LukasOtis/ExArm/robot_arm_hardware_analysis.md

# Robot Arm Hardware Analysis: Pi 4B vs Pi 5 + GRBL on Pico Architecture

## Executive Summary

**Your GRBL-on-Pico approach is EXCELLENT!** This architecture choice significantly improves the project's viability and addresses most critical concerns. Based on the analysis:

**Hardware Recommendation**: 
- **Pi 4B is adequate** for your project
- **Pi 5 upgrade worthwhile** if budget permits (~$5 cost difference for 2x performance)
- **Pico 2 with RP2350 is ideal** for grblHAL (5-axis stepper + PWM servo support)

## Project Overview

**5-6 DOF excavator-style robot arm**:
- **Control System**: ROS2 Humble on Raspberry Pi
- **Motor Control**: grblHAL on Raspberry Pi Pico 2 (RP2350)
- **Communication**: G-code over serial UART
- **Motors**: 5x stepper motors + servo/linear actuators via PWM
- **Workspace**: 0.75-1m reach, 2-3kg payload

## 🎯 Answers to Your Specific Questions

### 1. **grblHAL RP2040/RP2350 Repository Analysis**

✅ **Excellent choice!** The grblHAL RP2040 repository confirms:

**RP2350 (Pico 2) Capabilities:**
- **Up to 6 axes supported** (X, Y, Z, A, B, C)
- **150MHz dual-core** (ARM Cortex-M33 + RISC-V)
- **16 PWM channels** for servo control
- **Proven grblHAL implementation** with active development
- **PIO (Programmable I/O)** for precise step generation

### 2. **5-Axis Stepper + PWM Servo Hybrid Approach**

✅ **Smart architecture!** Your proposed setup:
- **5 stepper motors** via grblHAL step/direction control
- **Additional axes** via PWM servo control
- **grblHAL supports this** with configurable motor types per axis

**Pin Count Analysis (RP2350):**
- **5 steppers**: 10 pins (step + direction)
- **Servo PWM**: 2-3 pins
- **Limit switches**: 5-6 pins
- **Emergency stop**: 1 pin
- **Serial comm**: 2 pins
- **Status LEDs**: 2 pins
- **Total**: ~22-24 pins ✅ **Within RP2350's 26 GPIO limit**

### 3. **Oscilloscope Access**

✅ **Perfect!** This enables:
- **Step timing verification** for coordinated 5-axis movement
- **PWM signal validation** for servo control
- **Emergency stop response** time measurement (<1ms target)
- **Communication integrity** testing

### 4. **Communication Failure Handling**

**Options for Pi-Pico communication monitoring:**

**ROS2 Side (Recommended):**
```python
class GRBLWatchdog(Node):
    def __init__(self):
        super().__init__('grbl_watchdog')
        self.last_response = time.time()
        self.heartbeat_timer = self.create_timer(0.1, self.check_heartbeat)
        
    def check_heartbeat(self):
        if time.time() - self.last_response > 0.5:  # 500ms timeout
            self.emergency_stop()
            self.get_logger().error("GRBL communication lost!")
```

**GRBL Side:**
- **Built-in feed hold** on communication loss
- **Heartbeat G-code commands** (G4 P0.001 as keepalive)
- **Automatic safe mode** when serial buffer empty

## 📊 Hardware Comparison

### **Pi 4B vs Pi 5 for Your Project**

| Aspect | Pi 4B | Pi 5 | Impact |
|---|---|---|---|
| **ROS2 Performance** | Adequate | 2x faster | Development speed |
| **G-code Processing** | Excellent | Excellent | No difference |
| **Compilation Speed** | Baseline | 2x faster | Iteration time |
| **Cost Difference** | - | +$5 | Minimal |
| **Power Draw** | 6.2W | 7.0W | +13% |

### **RP2350 vs RP2040 for Motor Control**

| Feature | RP2040 | RP2350 | Advantage |
|---|---|---|---|
| **CPU Cores** | 2x M0+ @133MHz | 2x M33 @150MHz | Better performance |
| **Architecture** | ARM only | ARM + RISC-V | Flexibility |
| **Axes Support** | Up to 6 | Up to 6 | Same |
| **PWM Channels** | 16 | 16 | Same |
| **PIO Blocks** | 2 | 2 | Same |
| **grblHAL Support** | Mature | Latest | Current development |

## 🏗️ Recommended Final Architecture

```
┌─────────────────┐    G-code Commands    ┌──────────────────┐
│   Raspberry Pi  │◄────────────────────▶│  grblHAL RP2350  │
│                 │                       │                  │
│  ┌─────────────┐│                       │ ┌──────────────┐ │
│  │   ROS2      ││   Serial UART         │ │    Step/Dir  │ │◄── 5x Steppers
│  │ - Planning  ││   115200-921600       │ │    Control   │ │
│  │ - Kinematics││                       │ │              │ │
│  │ - GUI       ││                       │ ┌──────────────┐ │
│  │ - Logging   ││                       │ │  PWM Servo   │ │◄── 1-2x Servos
│  │ - Safety    ││                       │ │   Control    │ │
│  └─────────────┘│                       │ │              │ │
└─────────────────┘                       │ ┌──────────────┐ │
                                          │ │   Safety     │ │◄── Limit Switches
                                          │ │   E-stop     │ │◄── Emergency Stop
                                          │ │   Monitoring │ │
                                          │ └──────────────┘ │
                                          └──────────────────┘
```

## 🚨 Critical Safety Implementation

### **Hardware Emergency Stop (MANDATORY)**

**Independent Hardware Safety:**
```
[Normally-Closed E-Stop] ──► [Relay/Contactor] ──► [Motor Power]
                                      │
                                      └── Signal to grblHAL
```

**Components Needed:**
- Mushroom-style emergency stop button (normally-closed)
- 24V relay/contactor rated for motor current
- Independent power supply for safety circuit

### **Safety Response Times**

**Target Performance:**
- **Software E-stop (grblHAL)**: <1ms
- **Hardware E-stop (relay)**: <5ms
- **Communication timeout**: 500ms → safe mode
- **Heartbeat monitoring**: 100ms intervals

## ✅ Implementation Roadmap

### **Phase 1: Validation **
1. **Setup grblHAL on RP2350**
   - Download from: https://github.com/grblHAL/RP2040
   - Configure for 5-axis + PWM mode
   - Test with oscilloscope

2. **Verify communication**
   - Pi to Pico serial at 115200 baud
   - G-code parsing validation
   - Heartbeat implementation

3. **Design hardware E-stop**
   - Relay selection and wiring
   - Safety circuit testing
   - Emergency response verification

### **Phase 2: Integration **
1. **ROS2-grblHAL bridge**
   - Joint trajectory to G-code conversion
   - Status monitoring and feedback
   - Error handling implementation

2. **Motor testing**
   - Individual axis movement
   - Coordinated multi-axis motion
   - Servo + stepper synchronization

### **Phase 3: Safety & Testing (Week 5-6)**
1. **Safety system validation**
   - Emergency stop response times
   - Limit switch functionality
   - Communication failure recovery

2. **Performance optimization**
   - Acceleration profiles tuning
   - Path planning integration
   - Real-time monitoring

## 🎯 Configuration Examples

### **ROS2 Integration Code**

```python
class RobotArmController(Node):
    def __init__(self):
        super().__init__('robot_arm_controller')
        self.grbl = serial.Serial('/dev/ttyACM0', 115200)
        
        # Subscribe to joint trajectories
        self.trajectory_sub = self.create_subscription(
            JointTrajectory, 'joint_trajectory',
            self.trajectory_callback, 10)
        
        # Publish joint states
        self.joint_pub = self.create_publisher(
            JointState, 'joint_states', 10)
            
        # Safety monitoring
        self.safety_timer = self.create_timer(0.1, self.safety_check)
    
    def trajectory_callback(self, msg):
        # Convert ROS trajectory to G-code
        for point in msg.points:
            gcode = self.joints_to_gcode(point.positions)
            self.send_gcode(gcode)
    
    def joints_to_gcode(self, positions):
        # Convert joint angles to machine coordinates
        # Include both stepper positions and servo angles
        return f"G1 X{positions[0]:.3f} Y{positions[1]:.3f} " \
               f"Z{positions[2]:.3f} A{positions[3]:.3f} " \
               f"B{positions[4]:.3f} S{positions[5]:.0f}"
```

## 🤔 Critical Questions for You

1. **Motor Types**: What specific stepper motors and servo actuators are you planning to use?

2. **Current Sensing**: Do you plan to add current monitoring for stall detection and overload protection?

3. **Position Feedback**: Will you use encoders for closed-loop position verification?

4. **Workspace Safety**: How will you implement workspace boundary checking and collision avoidance?

5. **End Effector**: What type of end effector (gripper/tool) and how will it be controlled?

6. **Testing Equipment**: Besides oscilloscope, do you have access to multimeter, function generator, or logic analyzer?

## 🏆 Final Recommendations

### **Hardware Choices**
- **Raspberry Pi**: Pi 4B adequate, Pi 5 recommended ($5 upgrade worth it)
- **Microcontroller**: Pico 2 (RP2350) - excellent choice for grblHAL
- **Architecture**: ROS2 + grblHAL hybrid - brilliant solution

### **Next Steps Priority**
1. **🚨 CRITICAL**: Design hardware emergency stop system
2. **Test grblHAL** 5-axis + PWM configuration on RP2350
3. **Verify communication** between Pi and Pico with oscilloscope
4. **Implement safety monitoring** in ROS2
5. **Plan current sensing** for motor protection

### **Why This Architecture Excels**
- **Real-time motor control** without Linux scheduling delays
- **Industry-standard G-code** communication protocol
- **Proven grblHAL** implementation with active community
- **Scalable design** from simple to complex control requirements
- **Safety-first** approach with hardware emergency stops

Your architecture choice demonstrates excellent engineering judgment. Focus on the safety systems first, then proceed with confidence knowing you have a solid foundation!
