LukasOtis/ExArm/docs/TECHNICAL_ARCHITECTURE.md

# Technical Architecture

## System Overview
The robot arm control system consists of three main components:
1. **Raspberry Pi** - ROS2 control system
2. **Raspberry Pi Pico** - Motor control and hardware interface
3. **Robot Arm Hardware** - Stepper motors, encoders, and mechanical components

## Communication Architecture

### ROS2 Node Structure
```
robot_arm_control/
├── robot_arm_hardware_interface/    # Hardware abstraction layer
├── robot_arm_controller/            # Joint trajectory controller
├── robot_arm_planning/              # Path planning and optimization
├── robot_arm_gui/                   # Manual control interface
└── robot_arm_description/           # Robot model and parameters
```

### Communication Flow
```
GUI/Planning → Controller → Hardware Interface → Serial → Pico → Motors
     ↑                                                           ↓
     └────────────── Joint States ←──────────────────────────────┘
```

## Hardware Interface Design

### Serial Protocol (RPi ↔ Pico)
```
Message Format:
[START][CMD][DATA][CHECKSUM][END]

Commands:
- MOVE: Move joint to position
- HOME: Home all joints
- STATUS: Get current status
- EMERGENCY_STOP: Emergency stop
- SET_LIMITS: Set joint limits
- GET_POSITION: Get current position
```

### Joint Configuration
```
Joint 1: Base rotation (0-360°)
Joint 2: Shoulder rotation (0-180°)
Joint 3: Elbow rotation (0-180°)
Joint 4: Linear actuator 1 (0-100mm)
Joint 5: Linear actuator 2 (0-100mm)
Joint 6: End effector rotation (0-360°)
```

## Control System Architecture

### Joint Trajectory Controller
- **Input**: Trajectory messages from planning
- **Output**: Joint commands to hardware interface
- **Features**: 
  - Velocity and acceleration limits
  - Joint limit enforcement
  - Emergency stop handling

### Hardware Interface Node
- **Responsibilities**:
  - Serial communication management
  - Joint state publishing
  - Command execution
  - Error handling and recovery
  - Safety limit enforcement

### Safety System
- **Software Limits**: Joint angle and velocity limits
- **Hardware Limits**: Physical end stops and emergency stops
- **Emergency Stop**: Immediate halt of all movement
- **Collision Detection**: Workspace boundary checking

## Data Flow

### Control Commands
```
1. GUI/Planning sends trajectory goal
2. Controller validates trajectory
3. Controller sends joint commands to hardware interface
4. Hardware interface sends serial commands to Pico
5. Pico executes motor movements
6. Encoder feedback returns through same path
7. Joint states published for monitoring
```

### Safety Monitoring
```
1. Hardware interface monitors encoder feedback
2. Safety limits checked in real-time
3. Emergency stop triggered if limits exceeded
4. Status published to safety monitoring node
5. GUI updated with current status
```

## Performance Requirements

### Timing
- **Control Loop**: 50Hz (20ms period)
- **Safety Check**: 100Hz (10ms period)
- **GUI Update**: 10Hz (100ms period)
- **Serial Communication**: 115200 baud

### Latency Targets
- **Command to Motor**: < 50ms
- **Encoder to Joint State**: < 20ms
- **Emergency Stop**: < 10ms

## Error Handling

### Communication Errors
- Serial connection timeout handling
- Automatic reconnection attempts
- Fallback to safe positions

### Hardware Errors
- Motor stall detection
- Encoder failure handling
- Power loss recovery

### Software Errors
- Trajectory validation failures
- Controller errors
- Planning algorithm failures

## Development Phases

### Phase 1: Basic Control
- Simple joint movement commands
- Basic safety limits
- Manual control interface

### Phase 2: Advanced Control
- Trajectory following
- Path planning integration
- Advanced safety features

### Phase 3: Optimization
- Performance tuning
- Error recovery improvements
- User interface enhancements

## Testing Strategy

### Unit Testing
- Individual node testing
- Hardware interface simulation
- Controller algorithm validation

### Integration Testing
- End-to-end system testing
- Performance benchmarking
- Safety system validation

### Hardware Testing
- Real hardware integration
- Load testing
- Long-term reliability testing
