LukasOtis/ExArm/docs/PROJECT_STATUS.md

# Project Status Tracker

## Current Status: Phase 1 - Environment Setup
**Start Date**: [To be filled]
**Target Completion**: [To be filled]
**Progress**: 0% Complete

## Phase Progress

### Phase 1: Environment Setup (Week 1-2)
**Status**: 🔄 In Progress
**Progress**: 0/7 tasks completed

- [ ] **Day 1-2**: Install Ubuntu 22.04 in virtual environment
- [ ] **Day 3-4**: Install ROS2 Humble and development tools
- [ ] **Day 5**: Set up ROS2 workspace structure
- [ ] **Day 6-7**: Install Gazebo, RViz, and simulation tools
- [ ] **Week 2 Day 1-2**: Create project repository structure
- [ ] **Week 2 Day 3-4**: Set up development environment (IDE, debugging tools)
- [ ] **Week 2 Day 5-6**: Create initial robot description package
- [ ] **Week 2 Day 7**: Test basic ROS2 installation and tools

**Milestone 1**: Functional ROS2 environment with basic workspace
**Status**: ❌ Not Started

### Phase 2: Simulation & Design (Week 3-6)
**Status**: ⏳ Pending
**Progress**: 0/20 tasks completed

- [ ] **Week 3 Day 1-3**: Design robot URDF/XACRO structure
- [ ] **Week 3 Day 4-5**: Implement basic joint definitions
- [ ] **Week 3 Day 6-7**: Create visualization in RViz
- [ ] **Week 4 Day 1-3**: Set up Gazebo simulation environment
- [ ] **Week 4 Day 4-5**: Implement basic kinematics calculations
- [ ] **Week 4 Day 6-7**: Test joint limits and workspace simulation
- [ ] **Week 5 Day 1-3**: Design hardware interface architecture
- [ ] **Week 5 Day 4-5**: Plan serial communication protocol
- [ ] **Week 5 Day 6-7**: Create motor control interface design
- [ ] **Week 6 Day 1-3**: Implement basic trajectory planning
- [ ] **Week 6 Day 4-5**: Create safety limit implementations
- [ ] **Week 6 Day 6-7**: Test simulation with basic movements

**Milestone 2**: Functional simulation with basic control
**Status**: ❌ Not Started

### Phase 3: Core Control System (Week 7-10)
**Status**: ⏳ Pending
**Progress**: 0/20 tasks completed

- [ ] **Week 7 Day 1-3**: Create hardware interface package structure
- [ ] **Week 7 Day 4-5**: Implement serial communication with Pico
- [ ] **Week 7 Day 6-7**: Basic motor control interface
- [ ] **Week 8 Day 1-3**: Implement joint trajectory controller
- [ ] **Week 8 Day 4-5**: Create joint state publisher
- [ ] **Week 8 Day 6-7**: Test controller with simulation
- [ ] **Week 9 Day 1-3**: Implement safety limits and end stops
- [ ] **Week 9 Day 4-5**: Create emergency stop functionality
- [ ] **Week 9 Day 6-7**: Basic manual control interface
- [ ] **Week 10 Day 1-3**: Integrate hardware interface with simulation
- [ ] **Week 10 Day 4-5**: Test end-to-end control system
- [ ] **Week 10 Day 6-7**: Performance optimization and debugging

**Milestone 3**: Functional control system with safety features
**Status**: ❌ Not Started

### Phase 4: Advanced Features (Week 11-14)
**Status**: ⏳ Pending
**Progress**: 0/20 tasks completed

- [ ] **Week 11 Day 1-3**: Implement path planning algorithms
- [ ] **Week 11 Day 4-5**: Create trajectory optimization
- [ ] **Week 11 Day 6-7**: Test planning with complex paths
- [ ] **Week 12 Day 1-3**: Develop GUI for manual control
- [ ] **Week 12 Day 4-5**: Implement real-time position display
- [ ] **Week 12 Day 6-7**: Add manual joint control interface
- [ ] **Week 13 Day 1-3**: Implement error handling and recovery
- [ ] **Week 13 Day 4-5**: Add logging and debugging tools
- [ ] **Week 13 Day 6-7**: Create system monitoring interface
- [ ] **Week 14 Day 1-3**: Optimize control loop performance
- [ ] **Week 14 Day 4-5**: Implement advanced safety features
- [ ] **Week 14 Day 6-7**: Finalize GUI and user interface

**Milestone 4**: Complete control system with advanced features
**Status**: ❌ Not Started

### Phase 5: Testing & Integration (Week 15-18)
**Status**: ⏳ Pending
**Progress**: 0/20 tasks completed

- [ ] **Week 15 Day 1-3**: Hardware integration testing
- [ ] **Week 15 Day 4-5**: Real-world performance testing
- [ ] **Week 15 Day 6-7**: Calibration and tuning
- [ ] **Week 16 Day 1-3**: Load testing and stress testing
- [ ] **Week 16 Day 4-5**: Safety system validation
- [ ] **Week 16 Day 6-7**: Performance optimization
- [ ] **Week 17 Day 1-3**: Documentation completion
- [ ] **Week 17 Day 4-5**: User manual creation
- [ ] **Week 17 Day 6-7**: Code documentation and comments
- [ ] **Week 18 Day 1-3**: Final testing and validation
- [ ] **Week 18 Day 4-5**: Bug fixes and improvements
- [ ] **Week 18 Day 6-7**: Project completion and handover

**Milestone 5**: Production-ready robot arm control system
**Status**: ❌ Not Started

## Overall Project Metrics

### Timeline
- **Total Duration**: 18 weeks
- **Current Week**: 1
- **Weeks Remaining**: 17
- **Overall Progress**: 0%

### Risk Assessment
- **Hardware Design**: 🟡 Medium Risk (CAD design ongoing)
- **Software Complexity**: 🟢 Low Risk (Modular design)
- **Timeline**: 🟢 Low Risk (Realistic milestones)
- **Resource Availability**: 🟢 Low Risk (20 hours/week available)

### Success Metrics
- [ ] Robot arm responds to commands within 100ms
- [ ] Safety systems prevent dangerous movements
- [ ] GUI provides intuitive manual control
- [ ] Path planning handles complex trajectories
- [ ] System operates reliably for extended periods

## Weekly Updates

### Week 1 (Current)
**Focus**: RPi Environment Setup with X11 Forwarding
**Goals**:
- [ ] Set up RPi with ROS2 and X11 forwarding
- [ ] Install Cursor IDE and Remote-SSH extension
- [ ] Test X11 forwarding and RViz visualization
- [ ] Set up development workspace on RPi

**Challenges**: None identified yet
**Next Week**: Complete RPi setup and begin robot description with visualization

## Notes and Decisions

### Technical Decisions
- **ROS2 Version**: Humble (LTS)
- **Programming Language**: C++ for performance-critical components, Python for GUI
- **Communication Protocol**: Serial UART between RPi and Pico
- **Control Frequency**: 50Hz target

### Architecture Decisions
- **Modular Design**: Separate packages for different functionalities
- **Safety First**: Multiple safety layers (hardware + software)
- **Simulation Driven**: Develop and test in simulation before hardware

### Resource Allocation
- **Development Time**: 20 hours/week
- **Hardware Budget**: TBD
- **Software Tools**: Open source (ROS2, Gazebo, RViz)

## Action Items

### Immediate (This Week)
1. Set up virtual environment
2. Install ROS2 Humble
3. Test basic ROS2 functionality
4. Create initial project structure

### Short Term (Next 2 Weeks)
1. Complete environment setup
2. Create basic robot description
3. Set up visualization tools
4. Begin simulation development

### Medium Term (Next Month)
1. Implement basic control system
2. Design hardware interface
3. Create safety systems
4. Develop manual control interface

## Contact and Support
- **Project Lead**: [Your Name]
- **Technical Lead**: [Your Name]
- **Documentation**: This repository
- **Issues**: GitHub Issues
- **Discussions**: GitHub Discussions
