LukasOtis/ExArm/docs/PROJECT_TIMELINE.md

# ROS2 Robot Arm Project Timeline

## Phase 1: Environment Setup (Week 1-2)
**Goal**: Establish development environment and project structure

### Week 1
- [ ] **Day 1-2**: Set up RPi with ROS2 and X11 forwarding
- [ ] **Day 3-4**: Install Cursor IDE and Remote-SSH extension
- [ ] **Day 5**: Test X11 forwarding and RViz visualization
- [ ] **Day 6-7**: Set up development workspace and test robot model

### Week 2
- [ ] **Day 1-2**: Create project repository structure on RPi
- [ ] **Day 3-4**: Set up development environment with Cursor remote SSH
- [ ] **Day 5-6**: Create initial robot description package and test visualization
- [ ] **Day 7**: Test basic ROS2 installation and X11 forwarding

**Milestone 1**: Functional ROS2 environment with X11 forwarding and visualization

## Phase 2: Simulation & Design (Week 3-6)
**Goal**: Create simulation environment and robot description

### Week 3
- [ ] **Day 1-3**: Design robot URDF/XACRO structure
- [ ] **Day 4-5**: Implement basic joint definitions
- [ ] **Day 6-7**: Create visualization in RViz

### Week 4
- [ ] **Day 1-3**: Set up Gazebo simulation environment
- [ ] **Day 4-5**: Implement basic kinematics calculations
- [ ] **Day 6-7**: Test joint limits and workspace simulation

### Week 5
- [ ] **Day 1-3**: Design hardware interface architecture
- [ ] **Day 4-5**: Plan serial communication protocol
- [ ] **Day 6-7**: Create motor control interface design

### Week 6
- [ ] **Day 1-3**: Implement basic trajectory planning
- [ ] **Day 4-5**: Create safety limit implementations
- [ ] **Day 6-7**: Test simulation with basic movements

**Milestone 2**: Functional simulation with basic control

## Phase 3: Core Control System (Week 7-10)
**Goal**: Implement hardware interface and basic control

### Week 7
- [ ] **Day 1-3**: Create hardware interface package structure
- [ ] **Day 4-5**: Implement serial communication with Pico
- [ ] **Day 6-7**: Basic motor control interface

### Week 8
- [ ] **Day 1-3**: Implement joint trajectory controller
- [ ] **Day 4-5**: Create joint state publisher
- [ ] **Day 6-7**: Test controller with simulation

### Week 9
- [ ] **Day 1-3**: Implement safety limits and end stops
- [ ] **Day 4-5**: Create emergency stop functionality
- [ ] **Day 6-7**: Basic manual control interface

### Week 10
- [ ] **Day 1-3**: Integrate hardware interface with simulation
- [ ] **Day 4-5**: Test end-to-end control system
- [ ] **Day 6-7**: Performance optimization and debugging

**Milestone 3**: Functional control system with safety features

## Phase 4: Advanced Features (Week 11-14)
**Goal**: Implement advanced control and planning features

### Week 11
- [ ] **Day 1-3**: Implement path planning algorithms
- [ ] **Day 4-5**: Create trajectory optimization
- [ ] **Day 6-7**: Test planning with complex paths

### Week 12
- [ ] **Day 1-3**: Develop GUI for manual control
- [ ] **Day 4-5**: Implement real-time position display
- [ ] **Day 6-7**: Add manual joint control interface

### Week 13
- [ ] **Day 1-3**: Implement error handling and recovery
- [ ] **Day 4-5**: Add logging and debugging tools
- [ ] **Day 6-7**: Create system monitoring interface

### Week 14
- [ ] **Day 1-3**: Optimize control loop performance
- [ ] **Day 4-5**: Implement advanced safety features
- [ ] **Day 6-7**: Finalize GUI and user interface

**Milestone 4**: Complete control system with advanced features

## Phase 5: Testing & Integration (Week 15-18)
**Goal**: Hardware integration and final testing

### Week 15
- [ ] **Day 1-3**: Hardware integration testing
- [ ] **Day 4-5**: Real-world performance testing
- [ ] **Day 6-7**: Calibration and tuning

### Week 16
- [ ] **Day 1-3**: Load testing and stress testing
- [ ] **Day 4-5**: Safety system validation
- [ ] **Day 6-7**: Performance optimization

### Week 17
- [ ] **Day 1-3**: Documentation completion
- [ ] **Day 4-5**: User manual creation
- [ ] **Day 6-7**: Code documentation and comments

### Week 18
- [ ] **Day 1-3**: Final testing and validation
- [ ] **Day 4-5**: Bug fixes and improvements
- [ ] **Day 6-7**: Project completion and handover

**Milestone 5**: Production-ready robot arm control system

## Risk Mitigation
- **Hardware delays**: Continue with simulation development
- **Software complexity**: Focus on core functionality first
- **Performance issues**: Implement modular design for easy optimization
- **Safety concerns**: Implement multiple safety layers

## Success Criteria
- [ ] Robot arm responds to commands within 100ms
- [ ] Safety systems prevent dangerous movements
- [ ] GUI provides intuitive manual control
- [ ] Path planning handles complex trajectories
- [ ] System operates reliably for extended periods
