LukasOtis/ExArm/hardware/pcb/controller_board/assembly/BOM_with_all_Digi_Key_numbers.xlsx

BOM_with_all_Digi_Key_numbers
Designator | Footprint | Quantity | Value | LCSC Part # | comment | (Digi-Key) Name | Price e.a | Cost | status
A1 | RaspberryPi_Pico_Common_THT | 1 | RaspberryPi_Pico | C7203003 |  | - | €5.00 | €5.00 | in inventory
C1, C10, C16, C7 | CAP_EEFK_D8_PAN | 4 | EEE-FK1H470XP | C168842 |  | EEE-FK1H470XP | €0.33 | €1.32 | ordered
C11, C12, C2, C3 | 805 | 4 | 2.2uF | C125847 | 48V min | 581-KAM21KR71H225KU (mouser) | €0.22 | €0.88 | in inventory
C13, C4 | 603 | 2 | 0.1uF | C15725 | 48V min | GRM1885C1H101JA01D | 0.07 | €0.14 | ordered
C14, C5 | 603 | 2 | 2.2nF | C327023 | 5% | GRM1555C1H222GA01D | €0.05 | €0.10 | missed (1nF)
C15 | 603 | 1 | 50pF |  | 12V feedback loop | KYOCERA AVX | €0.15 | €0.15 | missed (65pF)
C17, C18, C8, C9 | 805 | 4 | 22uF |  | 20V ok | CL21A226MAYNNNE | €0.06 | €0.22 | ordered
C19, C20, C22, C23, C24, C26, C27, C28, C30, C31, C32, C34, C35, C36, C38, C42, C43, C44, C45, C48, C49, C52, C53 | 603 | 23 | 100nF |  |  | CC0603KRX7R7BB104 | €0.01 | €0.28 | need more
C21, C25, C29, C33, C37, C46, C51, C55 | 603 | 8 | 1uF |  |  | CL10B105KO8NNNC | €0.01 | €0.05 | ordered
C39 | 805 | 1 | 4.7uF | C125847 |  | C0805C475K4RACAUTO (mouser) | 0.12 | €0.12 | in inventory
C40 | 805 | 1 | 100nF | C15725 |  | KGM21NR71H104KT | €0.01 | €0.01 | ordered
C41 | 603 | 1 | 470pF |  |  | CL10C471JB8NNNC | €0.04 | €0.04 | ordered
C47, C50, C54 | 603 | 3 | 25uF |  | going with 22uF | GRM188R60J226MEA0J | €0.08 | €0.23 | ordered
C6 | 603 | 1 | 65pF |  | going with 68 | C0603C680J1GACTU | €0.04 | €0.04 | ordered
CR1, CR2 | DIODE_TO-277A | 2 | SS5P10-M3/86A |  |  | SS5P10-M3/86A | €0.40 | €0.80 | ordered
CR10, CR11, CR12, CR13, CR14, CR15, CR16, CR17, CR3, CR4, CR5, CR6, CR7, CR8, CR9 | SOT23_TO-236AB_NEX | 15 | PESD2CAN_215 | C800000 | TVS DIODE 24VWM 41VC TO236AB | PESD2CAN,215 | €0.21 | €3.15 | ordered
D1, D4 | SOD123W | 2 | D_Zener | C179519 |  | HPZR-C50-QX | €0.29 | €0.58 | ordered
D10, D12, D8 | D_SMB | 3 | SM6T39AY | C800000 | optional | TVS DIODE 18VWM 29.2VC DO214AA | €0.20 | €0.59 | ordered
D11, D2, D3, D5, D6, D7, D9 | 805 | 7 | LED | C39197 | orange | LED ORANGE CLEAR SMD | €0.08 | €0.53 | out
FB1, FB2 | 805 | 2 | FerriteBead |  | FERRITE BEAD 600 OHM 0805 1LN | MPZ2012S601AT000 | €0.06 | €0.13 | ordered
FB3, FB4, FB5, FB6, FB7, FB8 | 603 | 6 | FerriteBead |  | FERRITE BEAD 120 OHM 0603 1LN | BLM18KG121TN1D | €0.05 | €0.32 | ordered
J1, J2, J3, J4, J5 | CONN_SD-43045-010_08_MOL | 5 | 430450828 | C46703 | 10127721-082LF | CONN HEADER VERT 8POS 3MM | €0.41 | €2.04 | ordered
J10, J6, J7, J8, J9 | PinHeader_1x04_P2.54mm_Vertical | 5 | debug | C00000 | CONN HEADER VERT 4POS 2.54MM | PH1-04-UA | €0.04 | €0.21 | ordered
J11 | PinHeader_1x04_P2.54mm_Vertical | 1 | UART | C00000 | CONN HEADER VERT 4POS 2.54MM | PH1-04-UA | €0.04 | €0.04 | ordered
J12 | PinHeader_2x04_P2.54mm_Vertical | 1 | Conn_02x04_Odd_Even | C00000 | CONN HEADER VERT 8POS 2.54MM | PH2-08-UA | €0.11 | €0.11 | ordered
J13, J15, J17, J22, J24, J26 | PinHeader_2x02_P2.54mm_Vertical | 6 | Conn_02x02_Odd_Even | C00000 | CONN HEADER VERT 4POS 2.54MM | PH2-04-UA | €0.04 | €0.27 | ordered
J14, J16, J18, J23, J25, J27 | CONN_SD-43650-010_03_MOL | 6 | 436500328 | C46704 | CONN HEADER VERT 3POS 3MM | 66200311122 | €0.27 | €1.64 | ordered
J19, J20, J21 | TerminalBlock_MetzConnect_Type055_RT01502HDWU_1x02_P5.00mm_Horizontal | 3 | Screw_Terminal_01x02 |  | in set |  |  | €0.00 | in inventory
K1, K2, K3 | V-SOP4_special_OMR | 3 | G3VM-61VY3 |  | SSR RELAY SPST-NO 700MA 0-60V | G3VM-61VY3(TR05) | €1.28 | €3.84 | ordered
L1 | IND_1210-WE-PD_WRE | 1 | 7447709220 |  | FIXED IND 22UH 5.3A 28 MOHM SMD |  | €2.21 | €2.21 | ordered
L2 | IND_1210-WE-PD_WRE | 1 | 7447709470 |  | FIXED IND 47UH 3.8A 60 MOHM SMD |  | €2.21 | €2.21 | ordered
L3 | 1210 | 1 | 22uH |  | FIXED IND 22UH 250MA 923MOHM SMD | LQH32CN220K53L | €0.20 | €0.20 | ordered
R1, R7 | 805 | 2 | 10k |  | RES 10K OHM 1% 1/8W 0805 | RMCF0805FT10K0 | €0.02 | €0.04 | ordered
R10 | 603 | 1 | 453k 1% |  | RES SMD 453K OHM 1% 1/10W 0603 | ERJ-3EKF4533V | €0.03 | €0.03 | ordered
R11 | 603 | 1 | 50k 1% |  | RES 51K OHM 1% 1/10W 0603 | CRCW060351K0FKEAC | €0.03 | €0.03 | ordered
R12 | 805 | 1 | 2k |  | RES SMD 2K OHM 0.1% 1/8W 0805 | ERA-6AEB202V | €0.03 | €0.03 | ordered
R13, R14, R15, R16, R17, R18, R19, R20, R21, R22, R23, R24, R25, R26, R27, R28, R29, R30 | 603 | 18 | 10k |  | RES 10K OHM 1% 1/10W 0603 | RMCF0603FT10K0 | €0.01 | €0.20 | ordered
R2, R8 | 805 | 2 | 31.6kOhm |  | RES 31.6K OHM 1% 1/8W 0805 | RC0805FR-0731K6L | €0.01 | €0.02 | ordered
R3, R9 | 603 | 2 | 100k |  | RES 100K OHM 1% 1/10W 0603 | RMCF0603FT100K | €0.01 | €0.03 | ordered
R31, R32, R33 | 603 | 3 | 4.7k |  | RES SMD 4.7K OHM 0.1% 1/10W 0603 | ERA-3AEB472V | €0.05 | €0.16 | ordered
R34, R35, R36 | 805 | 3 | 0/10Ohm |  | RES SMD 0 OHM JUMPER 1/8W 0805 | ERJ-6GEY0R00V | €0.02 | €0.07 | ordered
R37, R38, R39 | 805 | 3 | 100 |  |  |  |  | €0.00 | in inventory
R4 | 603 | 1 | 316k 1% |  | RES 316K OHM 1% 1/10W 0603 | RMCF0603FT316K | €0.01 | €0.01 | ordered
R40, R42, R44 | 805 | 3 | 470 |  | RES 470 OHM 1% 1/8W 0805 | RMCF0805FT470R | €0.02 | €0.06 | ordered
R41, R43, R45 | 805 | 3 | 1k |  | RES SMD 1K OHM 1% 1/8W 0805 | CRCW08051K00FKEA | €0.04 | €0.11 | ordered
R5 | 603 | 1 | 100k 1% |  | RES SMD 100K OHM 0.1% 1/10W 0603 | RG1608P-104-B-T5 | €0.06 | €0.06 | ordered
R6 | 805 | 1 | 330 |  | RES SMD 330 OHM 5% 1/8W 0805 | ERJ-6GEYJ331V | €0.04 | €0.04 | ordered
R_ESR1, R_ESR2 | 603 | 2 | 20mOhm |  | RES 0.02 OHM 1% 1/4W 0603 | MFL0603R0200FA | €0.12 | €0.25 | ordered
U1, U2 | POWERPAD8_DDA_TEX | 2 | LM5013QDDARQ1 | C5219285 | IC REG BUCK ADJ 3.5A 8SOPWR | LM5013DDAR | €3.33 | €6.66 | ordered
U10, U12, U4, U6, U8 | SOIC-16_3.9x9.9mm_P1.27mm | 5 | AM26LS31CD | C2862931 | IC TRANSCEIVER 4/0 16SOIC | AM26LS31CDR | €0.37 | €1.84 | ordered
U11, U14, U3, U5, U7, U9 | DW0016B_M | 6 | ISO7730FDWR |  | DGTL ISOLTR 5KV 3CH GP 16-SOIC | ISO7730FDWR | €1.80 | €10.81 | ordered
U13 | OPEN-FRAME10_15.24X11.1X8_RCP | 1 | R2SX-1205/H-R |  | DC DC CONVERTER 5V 2W | R2SX-1205/H-R |  | €0.00 | optional
U15, U16, U17 | SOIC-8_M_MCH | 3 | MIC4420YM-TR | C628026 | IC GATE DRVR LOW-SIDE 8SOIC | MIC4420YM-TR | €1.50 | €4.50 | ordered
 |  |  |  |  |  |  | SUM | €52.38
