LukasOtis/ExArm/hardware/pcb/RP2350B_board/production/bom_partsnumber.xlsx

Designator | Footprint | Quantity | Value | Digikey Part number | Comment | Price | Cost
C1, C19, C5 | 0805 | 3 | 10uF | CL21A106KOQNNNE | CAP CER 10UF 16V X5R 0805 | €0.02 | €0.07
C10, C6, C7, C9 | 0402 | 4 | 4.7uF | CL05A475KP5NRNC | CAP CER 4.7UF 10V X5R 0402 | €0.08 | €0.31
C11, C12, C13, C14, C15, C16, C17, C18, C2, C20, C21, C8 | 0402 | 12 | 100nF | CL05B104KP5NNNC | CAP CER 0.1UF 10V X7R 0402 | €0.003 | €0.04
C22, R1, R11, R13, R9 | 0402 | 5 | DNF |  |  |  | €0.00
C3, C4 | 0402 | 2 | 15pF | GCM1555C1H150FA16D | CAP CER 15PF 50V C0G/NP0 0402 | €0.06 | €0.13
J1 | USB_Micro-B_Amphenol_10103594-0001LF_Horizontal | 1 | USB_B_Micro | 10103594-0001LF | CONN RCPT USB2.0 MICRO B SMD R/A | €0.64 | €0.64
J2, J3 | PinHeader_2x26_P2.54mm_Vertical | 2 | Conn_02x26_Odd_Even | - | ebay parts | €0.74 | €1.47
J4 | JST_SH_SM03B-SRSS-TB_1x03-1MP_P1.00mm_Horizontal | 1 | SM03B-SRSS-TB | SM03B-SRSS-TB (optional) | CONN HEADER SMD R/A 3POS 1MM | €0.38 | €0.38
L1 | L_pol_2016 | 1 | 3.3uH | AOTA-B201610S3R3-101-T | FIXED IND 3.3UH 2.4 A 140MOHM | €0.16 | €0.16
R10 | 0402 | 1 | 0 | CRCW04020000Z0EDHP | RES SMD 0 OHM JUMPER 1/5W 0402 | €0.03 | €0.03
R2, R4, R6 | 0402 | 3 | 1k | CRCW04021K00FKED | RES SMD 1K OHM 1% 1/16W 0402 | €0.02 | €0.06
R3 | 0402 | 1 | 33 | CRCW040233R0FKED | RES SMD 33 OHM 1% 1/16W 0402 | €0.03 | €0.03
R7, R8 | 0402 | 2 | 27 | ERJ-2RKF27R0X | RES SMD 27 OHM 1% 1/10W 0402 | €0.02 | €0.05
SW1, SW2 | SW_Push_1P1T_NO_Vertical_Wuerth_434133025816 | 2 | SW_Push | SWITCH TACTILE SPST-NO 0.05A 16V | 2nd optional | €0.46 | €0.92
U1 | RP2350-QFN-80-1EP_10x10_P0.4mm_EP3.4x3.4mm_ThermalVias | 1 | RP2350_80QFN | SC1510-A4 | RP2350B / 7" REEL | €1.03 | €1.03
U2 | SOT-223-3_TabPin2 | 1 | NCP1117-3.3_SOT223 | NCP1117LPST33T3G | IC REG LINEAR 3.3V 1A SOT-223 | €0.22 | €0.22
U3 | SOIC-8_5.23x5.23mm_P1.27mm | 1 | W25Q128JVS | W25Q32JVSSIQ (!smaller!) | IC FLASH 32MBIT SPI/QUAD 8SOIC | €0.65 | €0.65
U4 | SOIC-8_5.23x5.23mm_P1.27mm | 1 | DNF |  |  |  | €0.00
Y1 | Crystal_SMD_3225-4Pin_3.2x2.5mm | 1 | ABM8-272-T3 | ABM8-272-T3 | CRYSTAL 12.0000MHZ 10PF SMD | €0.64 | €0.64
 |  |  |  |  |  | TOTAL | €6.81
