LukasOtis/ExArm/hardware/pcb/RP2350B_board/RP2350_QFN80.step

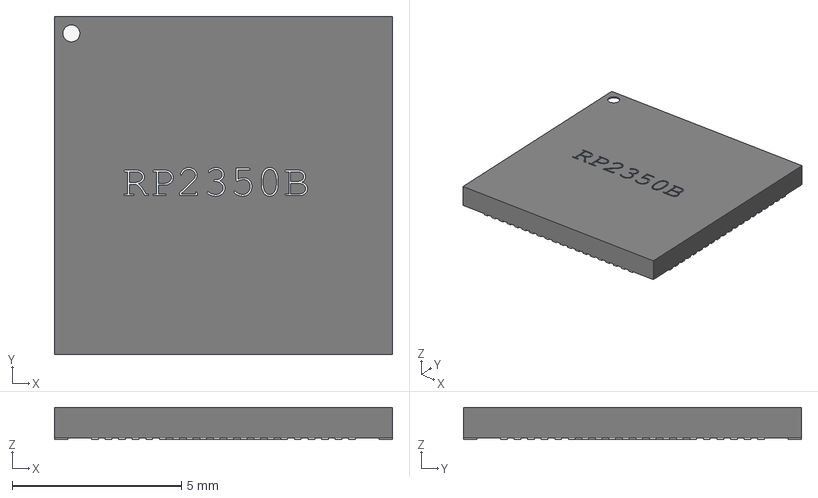
[picture p1: CAD file, 2025-11-30]
hardware/pcb/RP2350B_board/RP2350_QFN80.step
10.0 x 10.0 x 0.95 mm
