LukasOtis/ExArm/docs/VISUALIZATION_GUIDE.md

# Visualization Guide for RPi Development

## Overview
When developing on Raspberry Pi via SSH, you need special configuration to see GUI applications like RViz and Gazebo. This guide covers all visualization options.

## 🖥️ **Option 1: X11 Forwarding (Recommended for Development)**

### **Setup**
```bash
# Connect with X11 forwarding
ssh -X pi@raspberry-pi-ip

# Or with trusted X11 forwarding (better performance)
ssh -Y pi@raspberry-pi-ip
```

### **What You Get**
- ✅ **RViz windows** appear on your main computer
- ✅ **Gazebo simulation** displays on your main computer
- ✅ **Joint State Publisher GUI** works on your main computer
- ✅ **All ROS2 GUI tools** work normally

### **Performance**
- **Graphics rendering**: On RPi
- **Display**: On your main computer
- **Network**: Graphics data sent over SSH
- **Best for**: Development and testing

### **Usage Example**
```bash
# Connect with X11 forwarding
ssh -X pi@raspberry-pi-ip

# Run RViz (appears on your main computer)
ros2 run rviz2 rviz2

# Run robot arm visualization
ros2 launch robot_arm_description display.launch.py

# Run Gazebo simulation
ros2 launch gazebo_ros gazebo.launch.py
```

## 🖥️ **Option 2: VNC Server (Better Performance)**

### **Setup**
```bash
# On RPi, install VNC server
sudo apt install tightvncserver

# Start VNC server
vncserver :1 -geometry 1920x1080 -depth 24

# On your main computer, install VNC viewer
# Windows: Download RealVNC Viewer
# Mac: Download RealVNC Viewer
# Linux: sudo apt install tigervnc-viewer
```

### **Connect via VNC**
```bash
# Connect to RPi VNC server
# Address: raspberry-pi-ip:5901
# Username: pi
# Password: (set during vncserver setup)
```

### **What You Get**
- ✅ **Full desktop access** to RPi
- ✅ **Better graphics performance** - rendering on RPi
- ✅ **All GUI applications** work normally
- ✅ **Multiple applications** can run simultaneously
- ✅ **Cursor IDE** can run directly on RPi desktop

### **Performance**
- **Graphics rendering**: On RPi
- **Display**: On your main computer
- **Network**: Compressed video stream
- **Best for**: Complex simulations and full desktop work

### **Usage Example**
```bash
# On RPi desktop via VNC
cd ~/robot_arm_ws
source install/setup.bash

# Run RViz (appears on RPi desktop, displayed on your computer)
ros2 run rviz2 rviz2

# Run complex Gazebo simulation
ros2 launch gazebo_ros gazebo.launch.py
```

## 🖥️ **Option 3: Remote Desktop (Best Performance)**

### **Setup**
```bash
# On RPi, install remote desktop
sudo apt install xrdp

# Enable and start remote desktop
sudo systemctl enable xrdp
sudo systemctl start xrdp
```

### **Connect via RDP**
```bash
# Use Remote Desktop on Windows
# Use Microsoft Remote Desktop on Mac
# Use Remmina on Linux

# Connect to: raspberry-pi-ip
# Username: pi
# Password: your RPi password
```

### **What You Get**
- ✅ **Full desktop access** to RPi
- ✅ **Best graphics performance** - optimized for remote desktop
- ✅ **All applications** work normally
- ✅ **Multiple monitors** support
- ✅ **File sharing** between systems

### **Performance**
- **Graphics rendering**: On RPi
- **Display**: On your main computer
- **Network**: Optimized remote desktop protocol
- **Best for**: Production work and complex simulations

## 🔧 **Cursor IDE Integration**

### **With X11 Forwarding**
```bash
# Connect to RPi with X11 forwarding
ssh -X pi@raspberry-pi-ip

# In Cursor, connect via Remote-SSH
# SSH target: ssh -X pi@raspberry-pi-ip

# Edit code in Cursor
# Run visualization commands in terminal
ros2 launch robot_arm_description display.launch.py
```

### **With VNC**
```bash
# Connect to RPi desktop via VNC
# Install Cursor directly on RPi desktop
# Edit code directly on RPi
# Run visualizations on same desktop
```

### **With Remote Desktop**
```bash
# Connect to RPi desktop via RDP
# Install Cursor directly on RPi desktop
# Full development environment on RPi
```

## 📊 **Performance Comparison**

| Method | Graphics Performance | Setup Complexity | Network Usage | Best For |
|---|---|---|---|---|
| **X11 Forwarding** | ⭐⭐ Medium | ⭐ Simple | ⭐⭐ Medium | Development |
| **VNC** | ⭐⭐⭐ Good | ⭐⭐ Medium | ⭐⭐⭐ High | Complex simulations |
| **Remote Desktop** | ⭐⭐⭐⭐ Excellent | ⭐⭐ Medium | ⭐⭐⭐⭐ Very High | Production work |

## 🎯 **Recommendations by Use Case**

### **For Robot Arm Development**
**Recommended: X11 Forwarding**
- ✅ **Simple setup** - just add `-X` to SSH
- ✅ **Good performance** for RViz and basic Gazebo
- ✅ **Works with Cursor** remote SSH
- ✅ **Immediate testing** - see robot model instantly

### **For Complex Simulations**
**Recommended: VNC**
- ✅ **Better performance** for heavy simulations
- ✅ **Full desktop access** for debugging
- ✅ **Multiple applications** can run simultaneously
- ✅ **Cursor can run** directly on RPi desktop

### **For Production Work**
**Recommended: Remote Desktop**
- ✅ **Best performance** for all applications
- ✅ **Professional remote desktop** experience
- ✅ **File sharing** between systems
- ✅ **Multiple monitor** support

## 🚀 **Quick Setup for Your Project**

### **Step 1: Enable X11 Forwarding (Start Here)**
```bash
# On RPi, the setup script already configures this
# Connect with X11 forwarding
ssh -X pi@raspberry-pi-ip

# Test visualization
ros2 run rviz2 rviz2
```

### **Step 2: If You Need Better Performance**
```bash
# Install VNC server
sudo apt install tightvncserver

# Start VNC server
vncserver :1 -geometry 1920x1080 -depth 24

# Connect via VNC viewer
# Address: raspberry-pi-ip:5901
```

### **Step 3: For Production Work**
```bash
# Install remote desktop
sudo apt install xrdp
sudo systemctl enable xrdp
sudo systemctl start xrdp

# Connect via RDP
# Address: raspberry-pi-ip
```

## 🛠️ **Troubleshooting**

### **X11 Forwarding Issues**
```bash
# Check if X11 forwarding is enabled
ssh -X pi@raspberry-pi-ip "echo \$DISPLAY"

# Should show something like: :10.0

# If not working, check SSH config
sudo nano /etc/ssh/sshd_config
# Ensure these lines exist:
# X11Forwarding yes
# X11DisplayOffset 10
```

### **VNC Connection Issues**
```bash
# Check VNC server status
vncserver -list

# Kill existing VNC sessions
vncserver -kill :1

# Start new VNC session
vncserver :1 -geometry 1920x1080 -depth 24
```

### **Performance Issues**
```bash
# Check network speed
speedtest-cli

# Use wired connection if possible
# Ensure both devices on same network
# Close unnecessary applications on RPi
```

## 🎯 **For Your Robot Arm Project**

**Start with X11 Forwarding** because:
1. **Simple setup** - just add `-X` to SSH
2. **Good for RViz** - perfect for robot visualization
3. **Works with Cursor** - seamless development experience
4. **Immediate testing** - see robot model instantly
5. **Hardware integration** - test motors with visual feedback

**Upgrade to VNC if needed** when:
- Running complex Gazebo simulations
- Need better graphics performance
- Want full desktop access
- Working with multiple applications

This gives you the best of both worlds: **simple development** with **full visualization support**!
