LukasOtis/ExArm/grblhal_integration/firmware_GRBL/build/pico-sdk/src/rp2_common/pico_cyw43_driver/pioasm/src/pioasmBuild-stamp/pioasmBuild-source_dirinfo.txt

# This is a generated file and its contents are an internal implementation detail.
# The download step will be re-executed if anything in this file changes.
# No other meaning or use of this file is supported.

method=source_dir
command=
source_dir=/Users/lukasnoll/.pico-sdk/sdk/2.1.1/tools/pioasm
work_dir=
