LukasOtis/ExArm/docs/IMMEDIATE_NEXT_STEPS.md

# Immediate Next Steps

## Week 1: Environment Setup

### Day 1-2: Virtual Environment Setup
1. **Install VirtualBox or VMware**
   - Download VirtualBox 7.0+ or VMware Workstation
   - Allocate 4GB RAM, 2 CPU cores minimum
   - Allocate 50GB storage space

2. **Install Ubuntu 22.04 LTS**
   - Download Ubuntu 22.04 Desktop ISO
   - Install with default settings
   - Enable guest additions for better performance

### Day 3-4: ROS2 Installation
1. **System Preparation**
   ```bash
   sudo apt update && sudo apt upgrade
   sudo apt install curl gnupg2 lsb-release
   ```

2. **Install ROS2 Humble**
   ```bash
   # Add ROS2 repository
   sudo curl -sSL https://raw.githubusercontent.com/ros/rosdistro/master/ros.key -o /usr/share/keyrings/ros-archive-keyring.gpg
   echo "deb [arch=$(dpkg --print-architecture) signed-by=/usr/share/keyrings/ros-archive-keyring.gpg] http://packages.ros.org/ros2/ubuntu $(. /etc/os-release && echo $UBUNTU_CODENAME) main" | sudo tee /etc/apt/sources.list.d/ros2.list > /dev/null
   
   # Install ROS2 Humble
   sudo apt update
   sudo apt install ros-humble-desktop
   ```

3. **Environment Setup**
   ```bash
   # Add to ~/.bashrc
   echo "source /opt/ros/humble/setup.bash" >> ~/.bashrc
   source ~/.bashrc
   ```

### Day 5: Development Tools
1. **Install Additional Tools**
   ```bash
   sudo apt install python3-colcon-common-extensions
   sudo apt install python3-rosdep
   sudo rosdep init
   rosdep update
   ```

2. **Install Simulation Tools**
   ```bash
   sudo apt install ros-humble-gazebo-ros-pkgs
   sudo apt install ros-humble-rviz2
   sudo apt install ros-humble-joint-state-publisher-gui
   ```

### Day 6-7: Workspace Setup
1. **Create ROS2 Workspace**
   ```bash
   mkdir -p ~/robot_arm_ws/src
   cd ~/robot_arm_ws
   colcon build
   ```

2. **Test Installation**
   ```bash
   # Terminal 1
   ros2 run demo_nodes_cpp talker
   
   # Terminal 2
   ros2 run demo_nodes_py listener
   ```

## Week 2: Project Structure

### Day 1-2: Repository Setup
1. **Clone Project Repository**
   ```bash
   cd ~/robot_arm_ws/src
   git clone <your-repo-url>
   ```

2. **Create Package Structure**
   ```bash
   # Create packages
   ros2 pkg create --build-type ament_cmake robot_arm_description
   ros2 pkg create --build-type ament_cmake robot_arm_control
   ros2 pkg create --build-type ament_cmake robot_arm_hardware
   ros2 pkg create --build-type ament_cmake robot_arm_gui
   ros2 pkg create --build-type ament_cmake robot_arm_planning
   ```

### Day 3-4: Basic Robot Description
1. **Create URDF File**
   ```xml
   <!-- robot_arm_description/urdf/robot_arm.urdf.xacro -->
   <?xml version="1.0"?>
   <robot name="robot_arm" xmlns:xacro="http://www.ros.org/wiki/xacro">
     <!-- Basic joint definitions for 6-DOF arm -->
   </robot>
   ```

2. **Create Launch Files**
   ```python
   # robot_arm_description/launch/display.launch.py
   from launch import LaunchDescription
   from launch_ros.actions import Node
   ```

### Day 5-6: Initial Testing
1. **Test Robot Description**
   ```bash
   ros2 launch robot_arm_description display.launch.py
   ```

2. **Test RViz Visualization**
   - Open RViz
   - Add RobotModel display
   - Verify joint movement

### Day 7: Development Environment
1. **Install IDE (VS Code)**
   ```bash
   sudo snap install code --classic
   ```

2. **Install ROS2 Extensions**
   - ROS2 extension for VS Code
   - Python extension
   - C++ extension

## Immediate Action Items

### Today (Priority 1)
1. **Set up virtual environment**
   - Install VirtualBox/VMware
   - Download Ubuntu 22.04 ISO
   - Begin installation

### This Week (Priority 2)
1. **Complete ROS2 installation**
   - Follow installation guide
   - Test basic functionality
   - Set up development tools

### Next Week (Priority 3)
1. **Create project structure**
   - Set up ROS2 workspace
   - Create initial packages
   - Test basic robot description

## Success Criteria for Week 1
- [ ] Virtual environment running Ubuntu 22.04
- [ ] ROS2 Humble installed and functional
- [ ] Basic ROS2 communication test working
- [ ] RViz and Gazebo installed
- [ ] Development environment ready

## Success Criteria for Week 2
- [ ] Project repository cloned
- [ ] All packages created and building
- [ ] Basic robot description working in RViz
- [ ] Development environment configured
- [ ] Ready to begin simulation development

## Troubleshooting Tips

### Common Issues
1. **Virtual Machine Performance**
   - Enable virtualization in BIOS
   - Allocate sufficient RAM (4GB+)
   - Install guest additions

2. **ROS2 Installation Issues**
   - Check Ubuntu version compatibility
   - Verify repository setup
   - Check network connectivity

3. **Build Issues**
   - Ensure all dependencies installed
   - Check Python version compatibility
   - Verify colcon installation

## Next Phase Preparation
- Research stepper motor control protocols
- Study GRBL firmware for Pico
- Plan serial communication protocol
- Design hardware interface architecture
