LukasOtis/ExArm/hardware/pcb/controller_board/assembly/Pico2Breakout.pdf

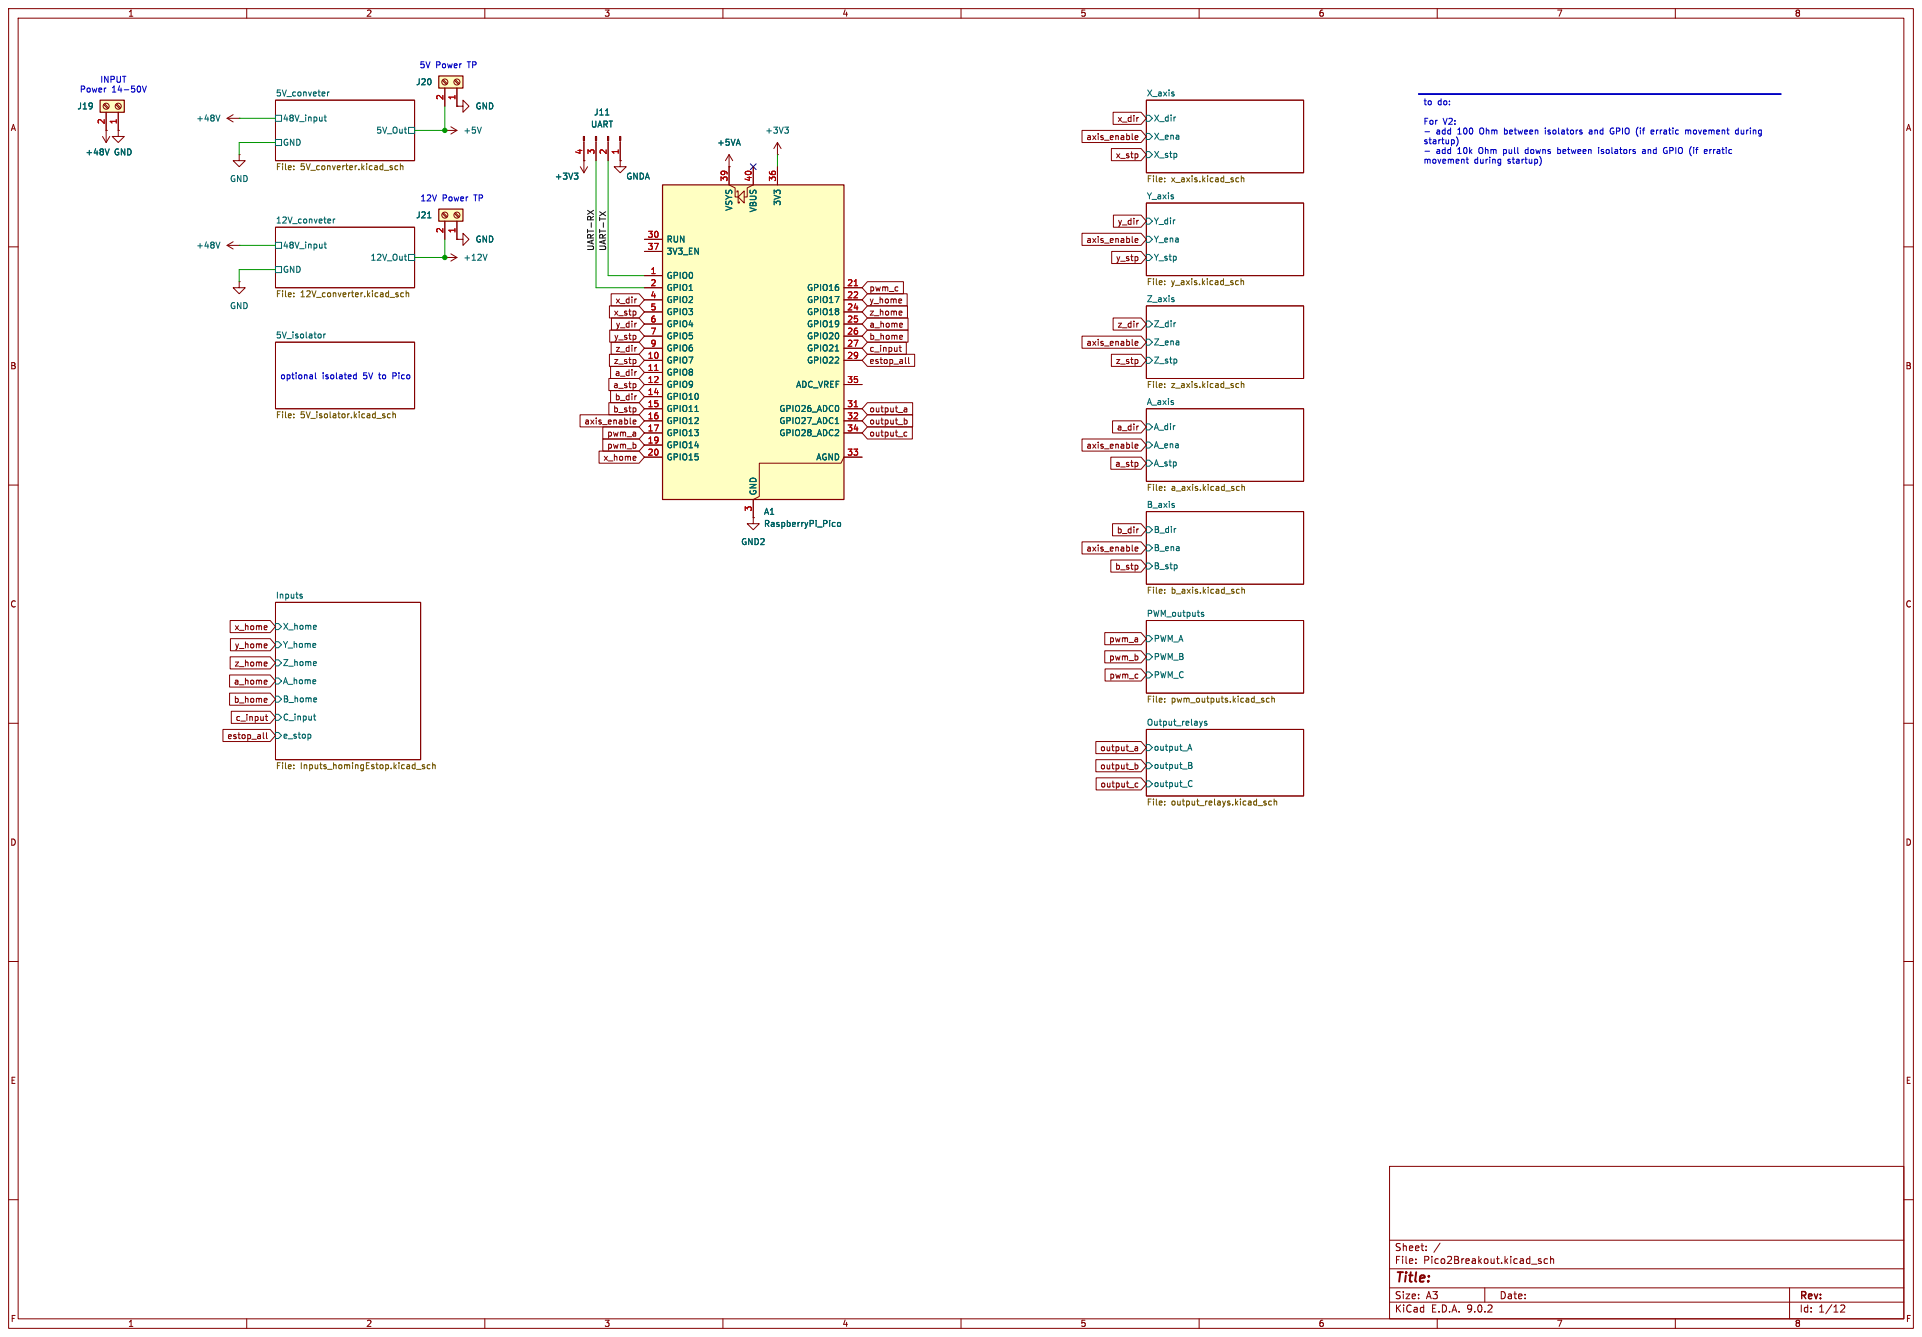
[picture p2: page 1]

Y_dir Y_ena Y_stp Y_axis File: y_axis.kicad_sch X_dir X_ena X_stp X_axis File: x_axis.kicad_sch B_dir B_ena B_stp B_axis File: b_axis.kicad_sch A_dir A_ena A_stp A_axis File: a_axis.kicad_sch Z_dir Z_ena Z_stp Z_axis File: z_axis.kicad_sch +12V

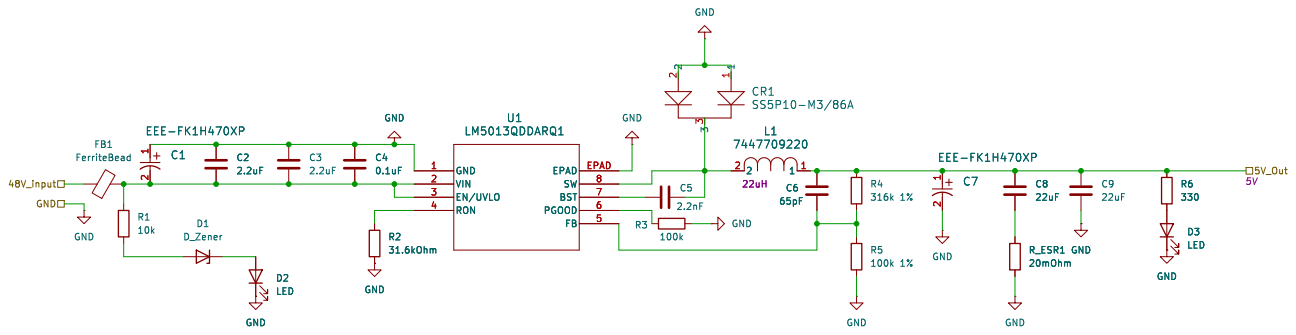
[picture p3: page 2]

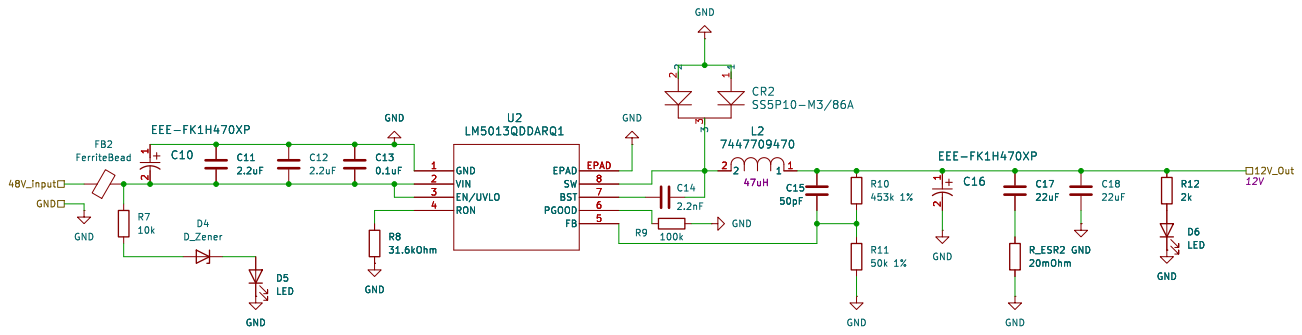
[picture p4: page 3]

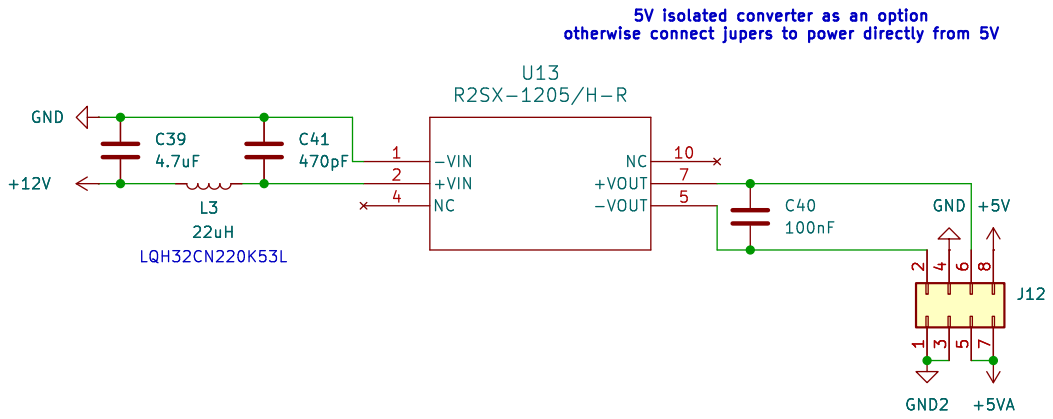
[picture p5: page 4]

5V isolated converter as an option

otherwise connect jupers to power directly from 5V C41

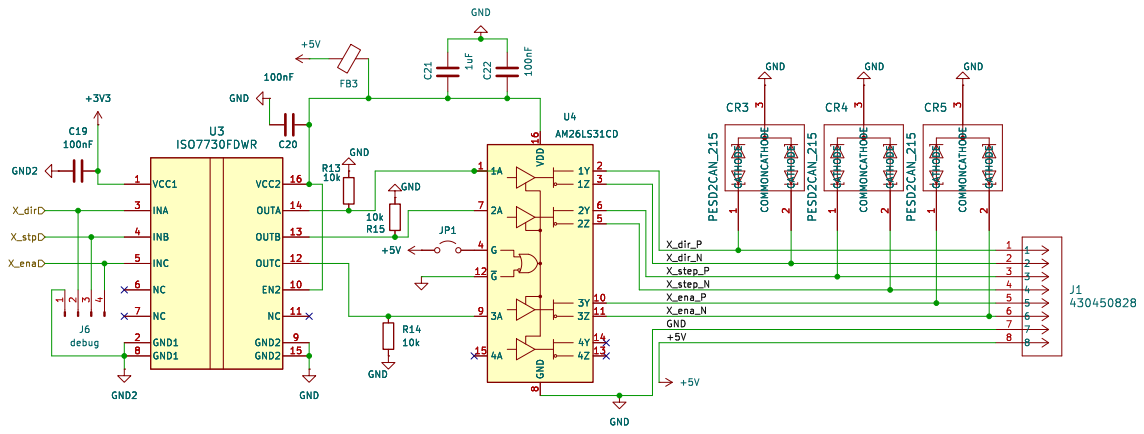
[picture p6: page 5]

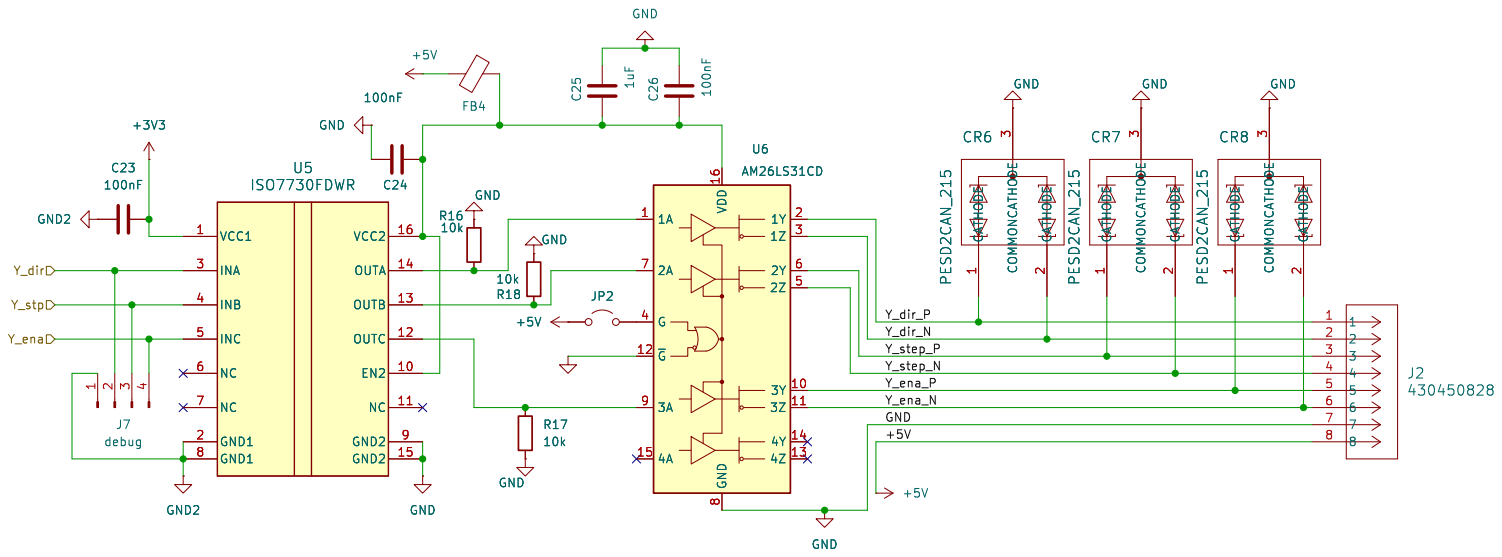
[picture p7: page 6]

Id: 6/12 Title: File: y_axis.kicad_sch Sheet: /Y_axis/

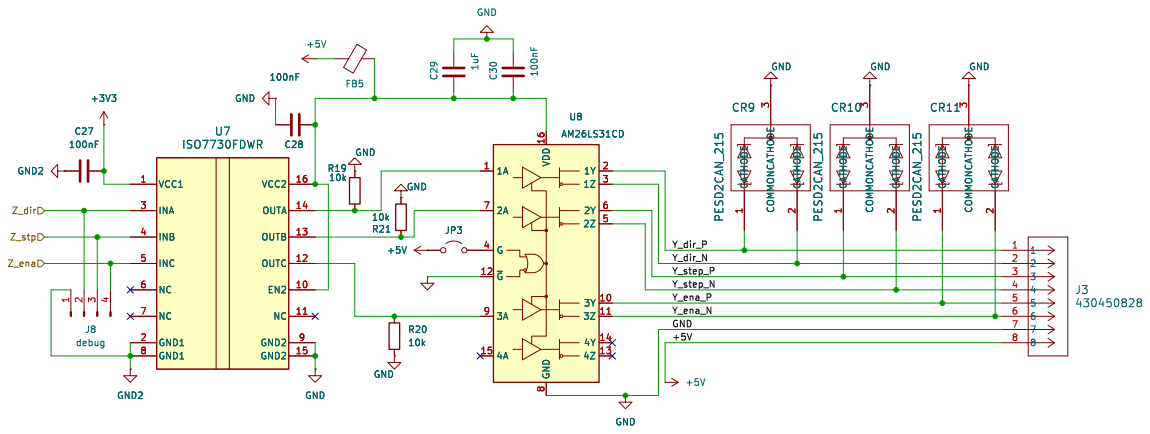
[picture p8: page 7]

3CR10 PESD2CAN_215 GND GND C30 100nF GND GND2 +3V3 GND2 GND

Id: 7/12 Title: File: z_axis.kicad_sch Sheet: /Z_axis/ CATHODE

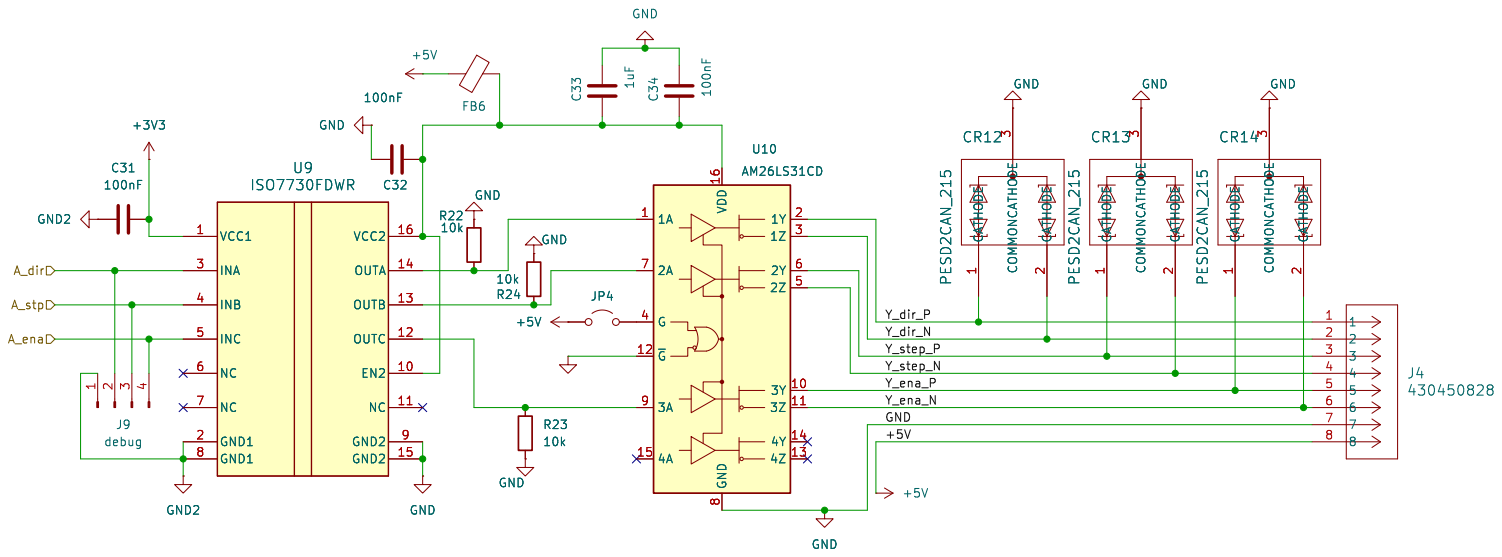
[picture p9: page 8]

Id: 8/12 Title: File: a_axis.kicad_sch Sheet: /A_axis/ CATHODE

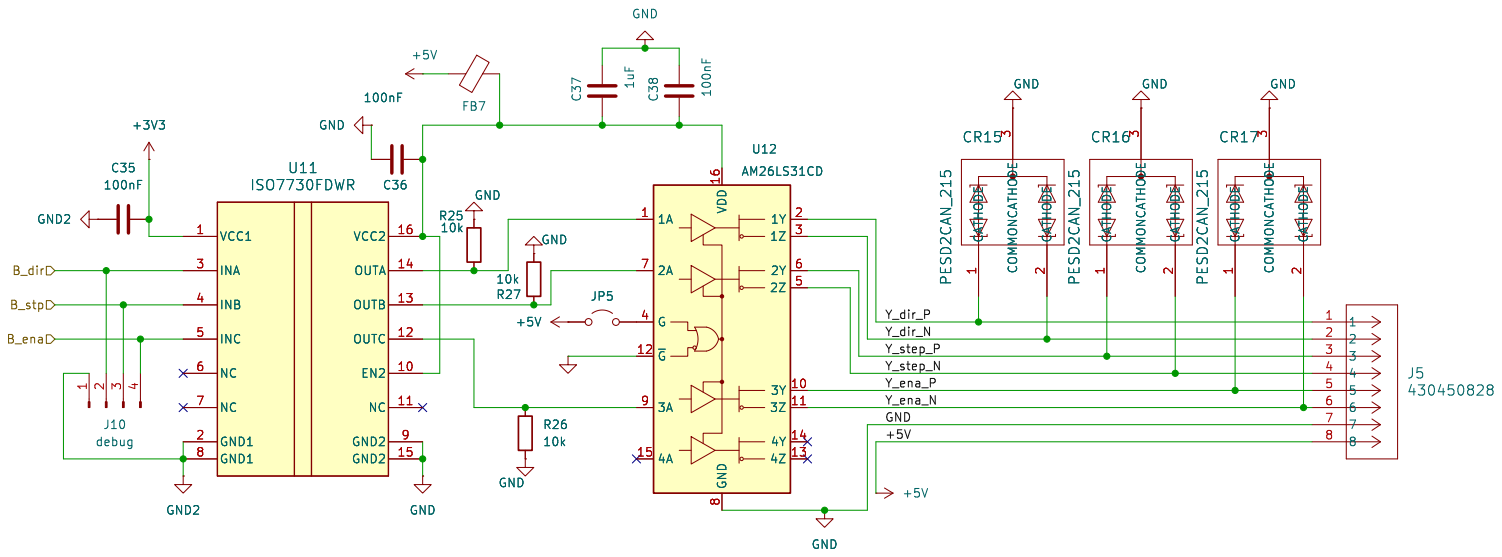
[picture p10: page 9]

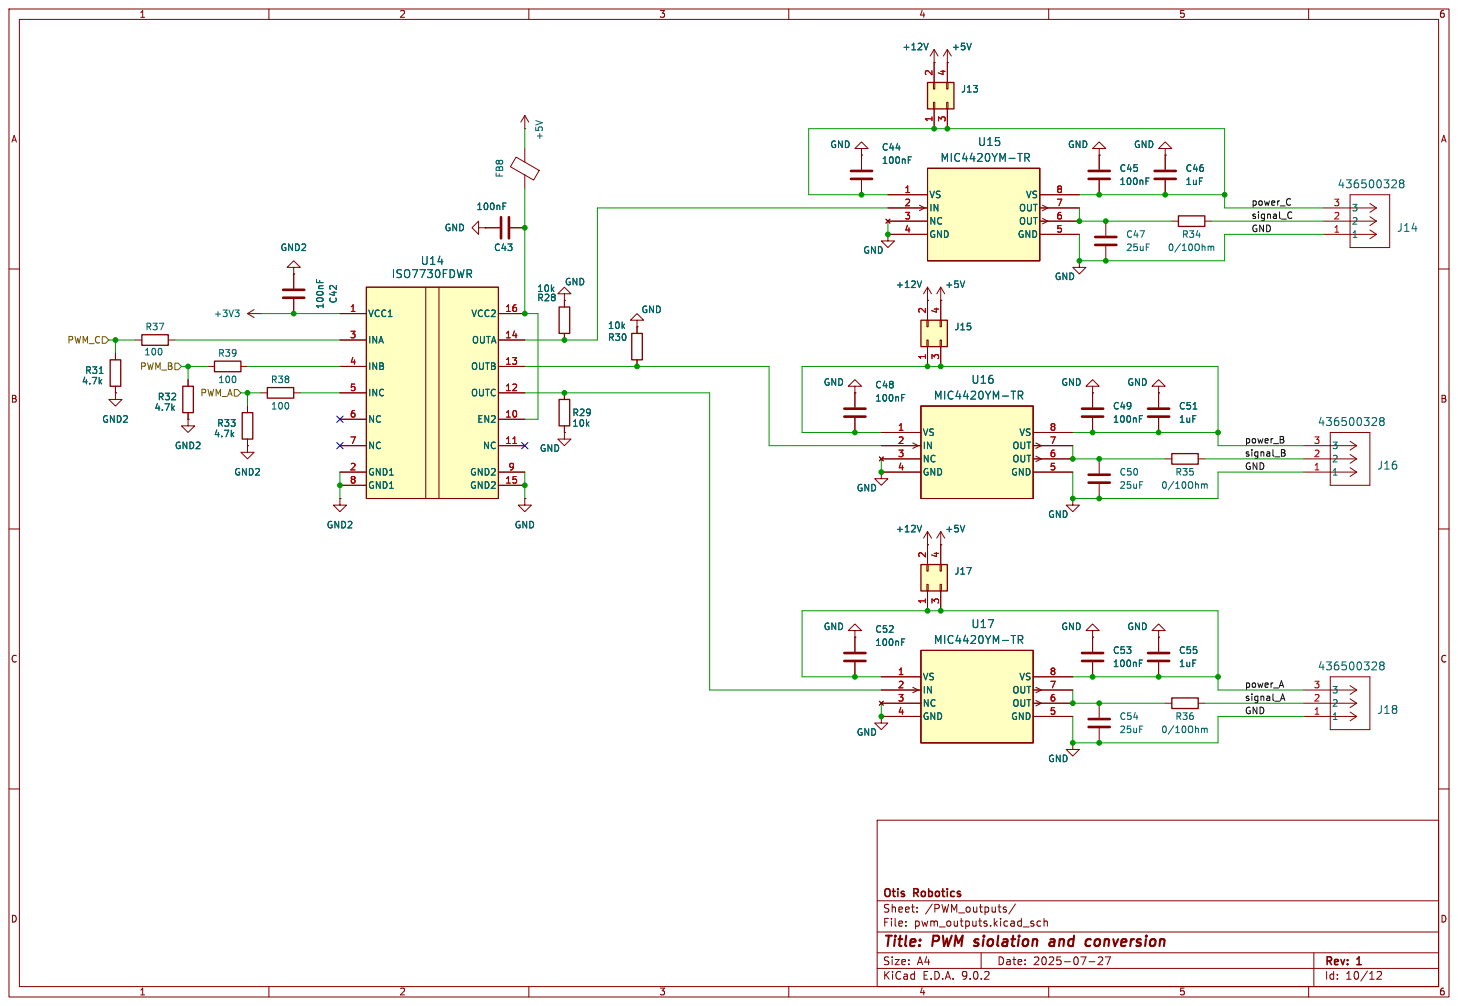
[picture p11: page 10]

Id: 10/12 Title: PWM siolation and conversion

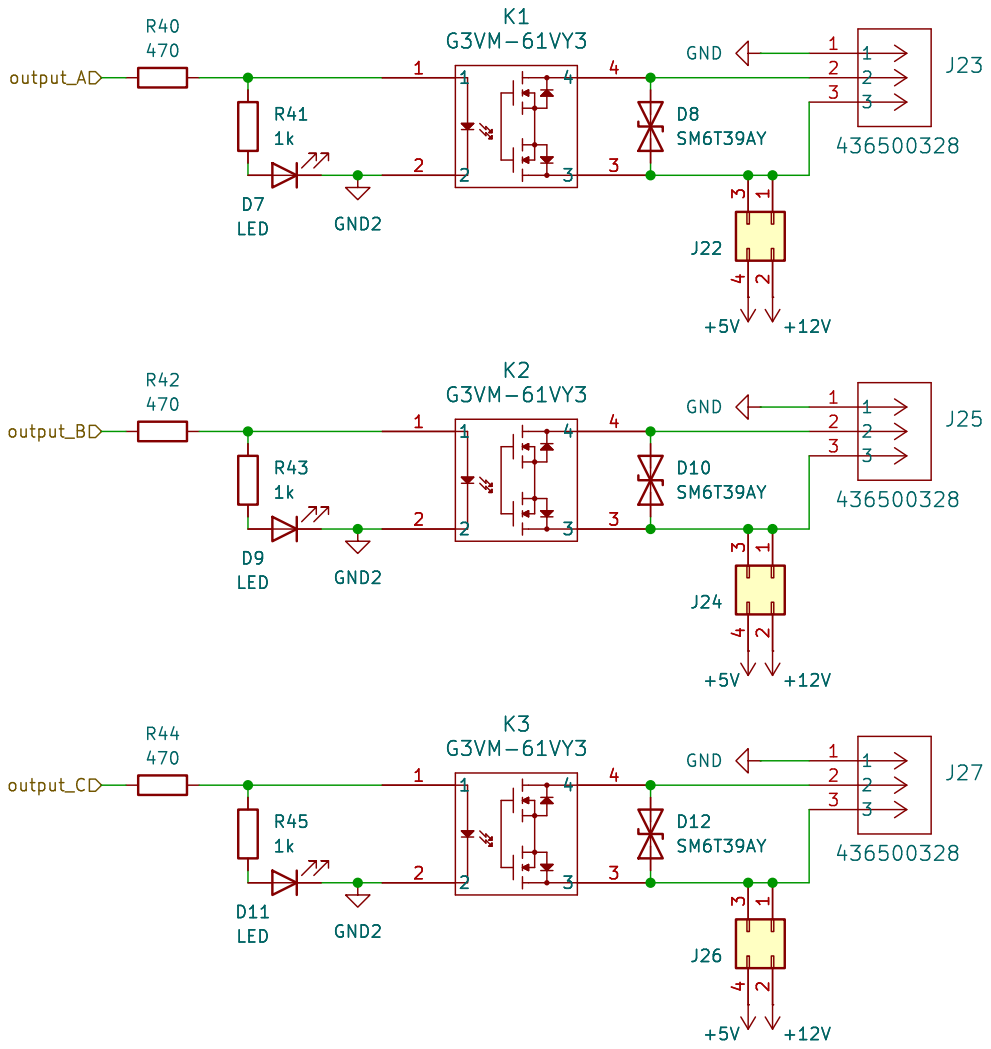
[picture p12: page 11]

Id: 11/12 Title: Solid state relay drivers 0.7A max

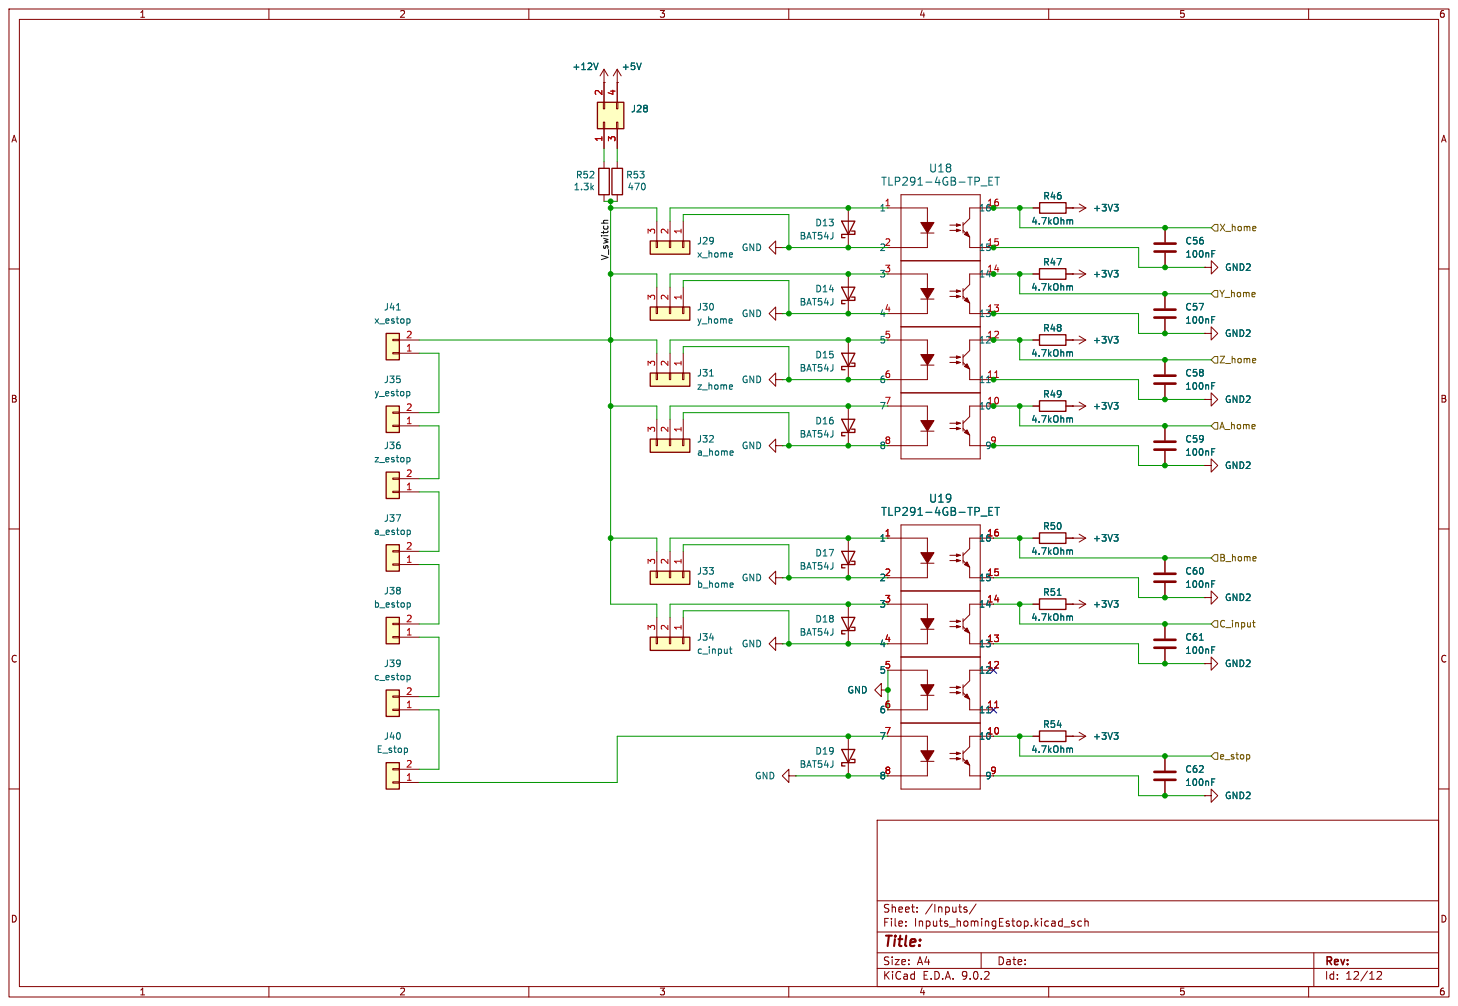
[picture p13: page 12]
