LukasOtis/ExArm/hardware/pcb/controller_board/assembly/PicoBreakout_V1.pdf

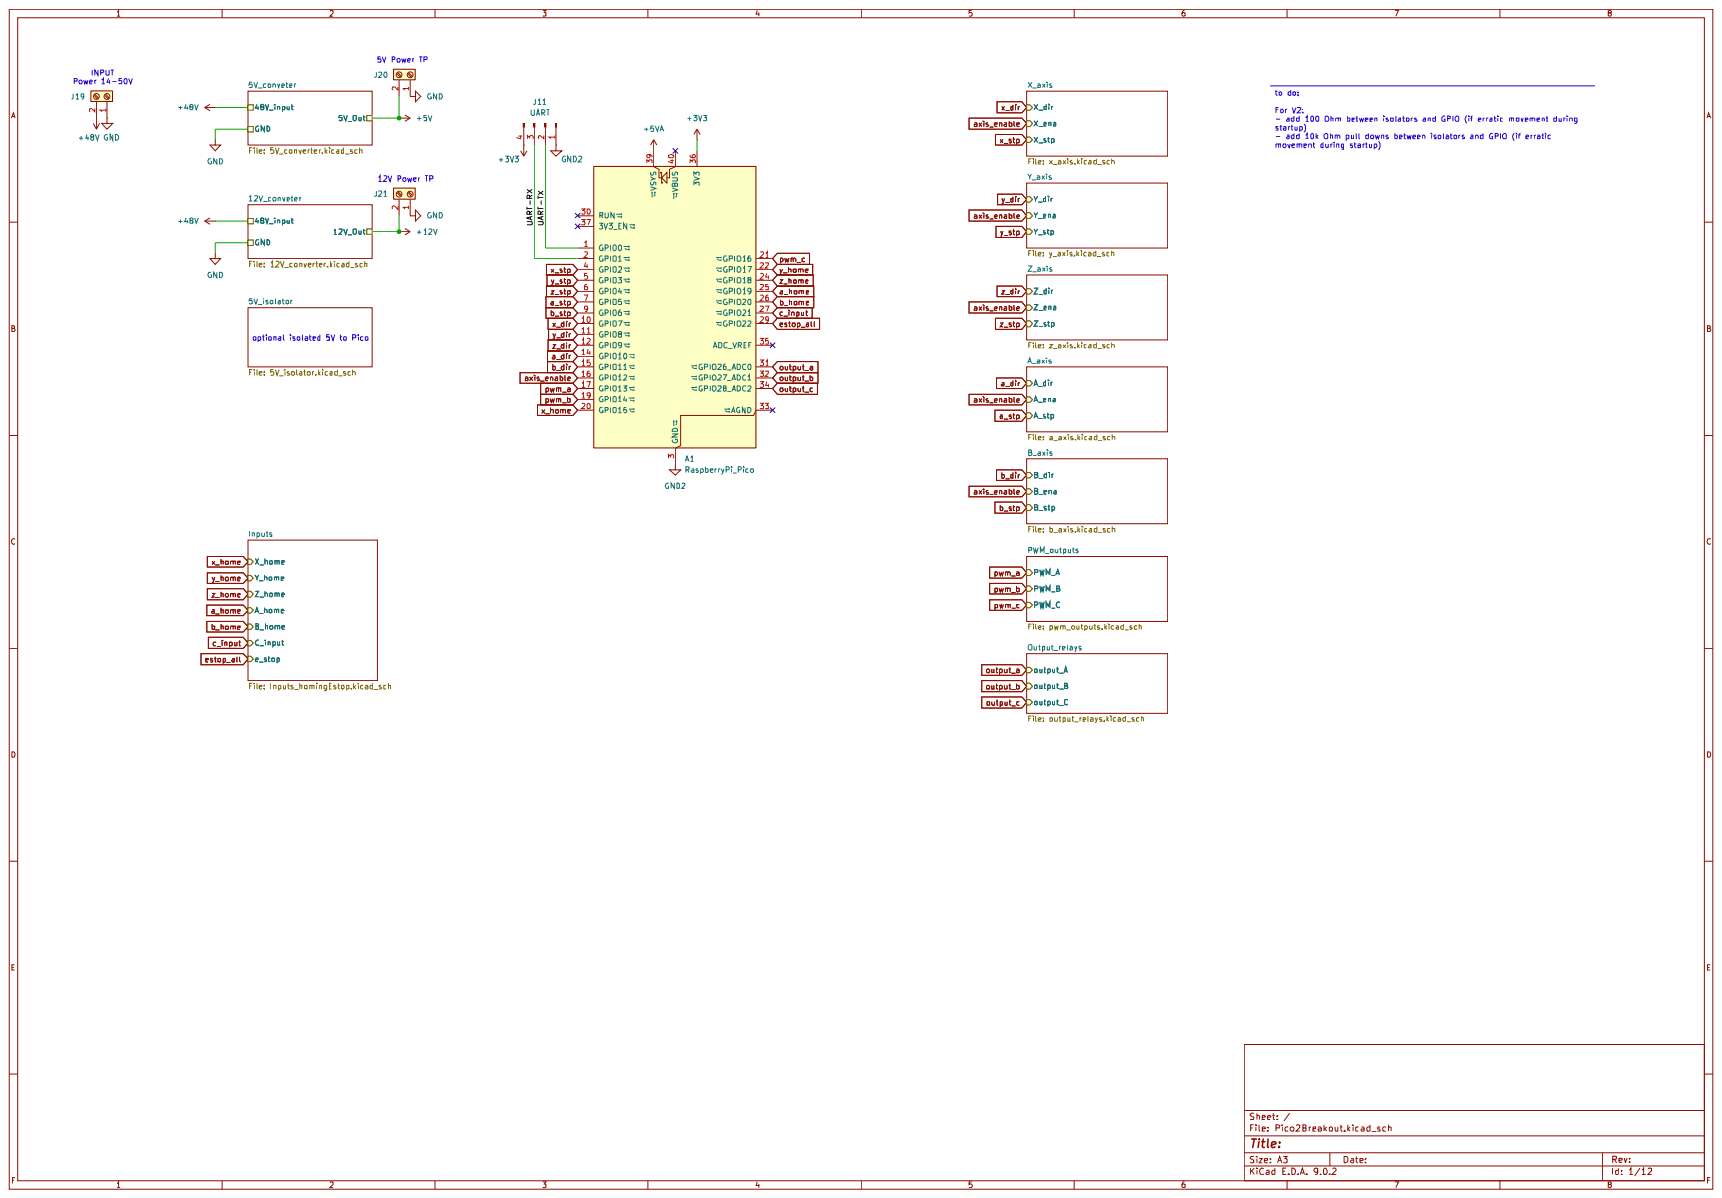
[picture p14: page 1]

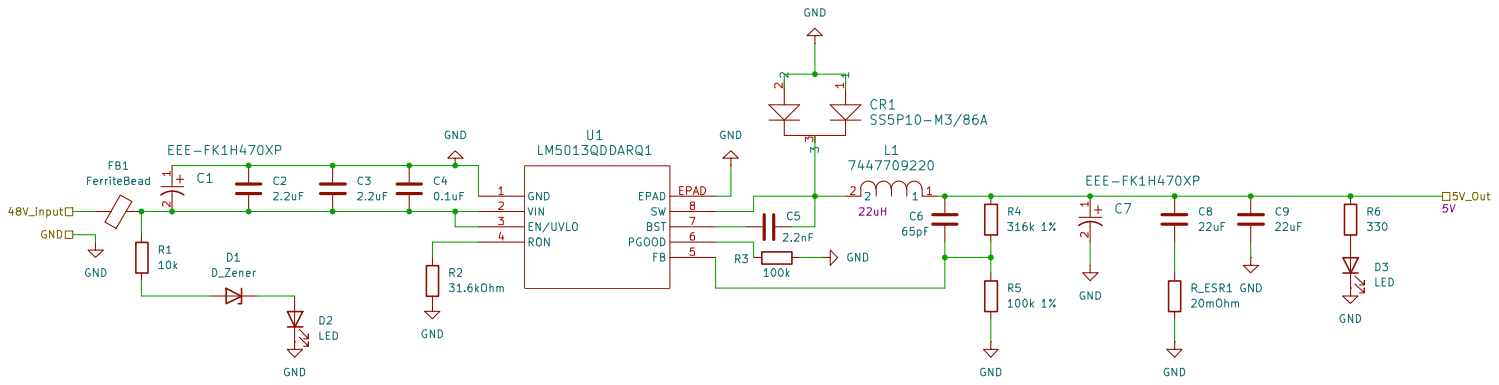
[picture p15: page 2]

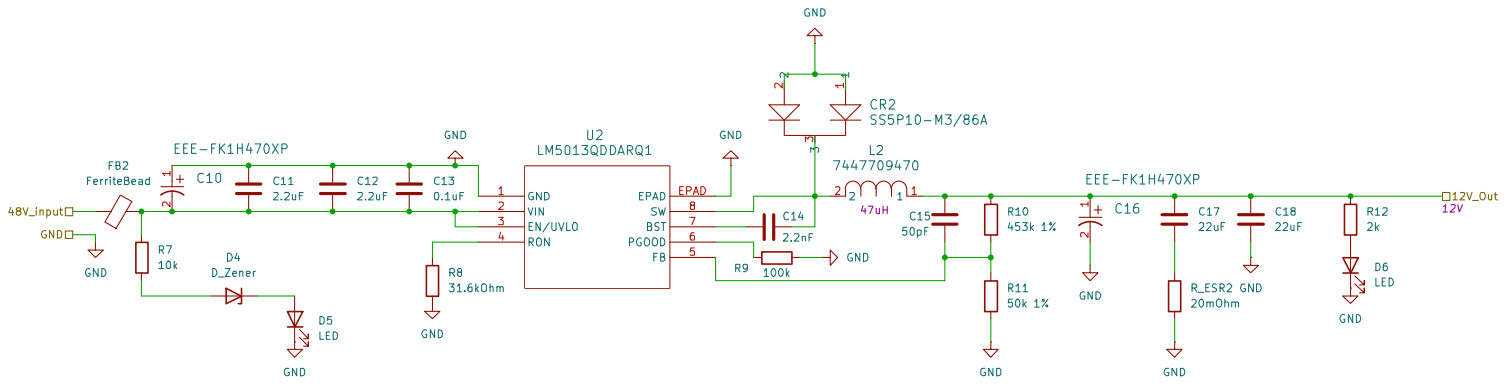
[picture p16: page 3]

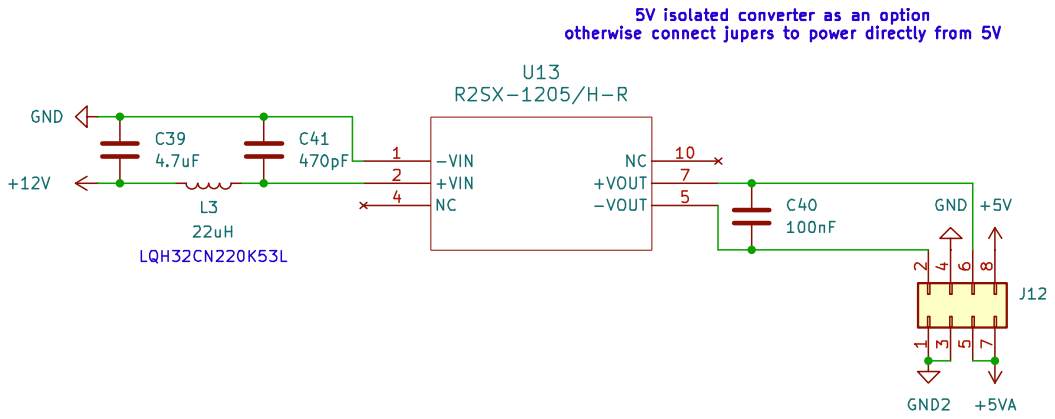
[picture p17: page 4]

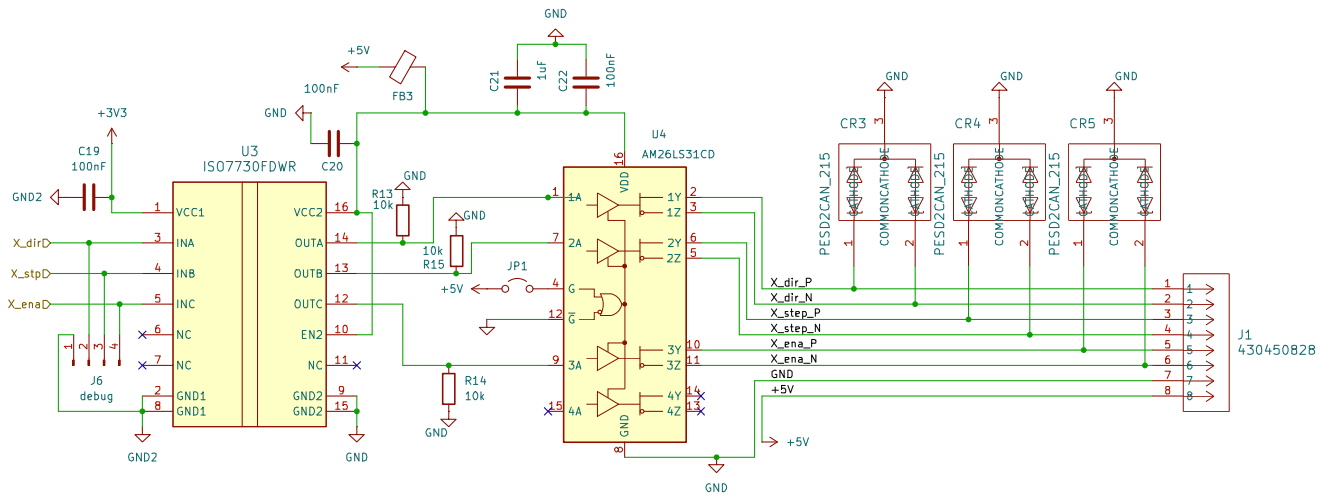
[picture p18: page 5]

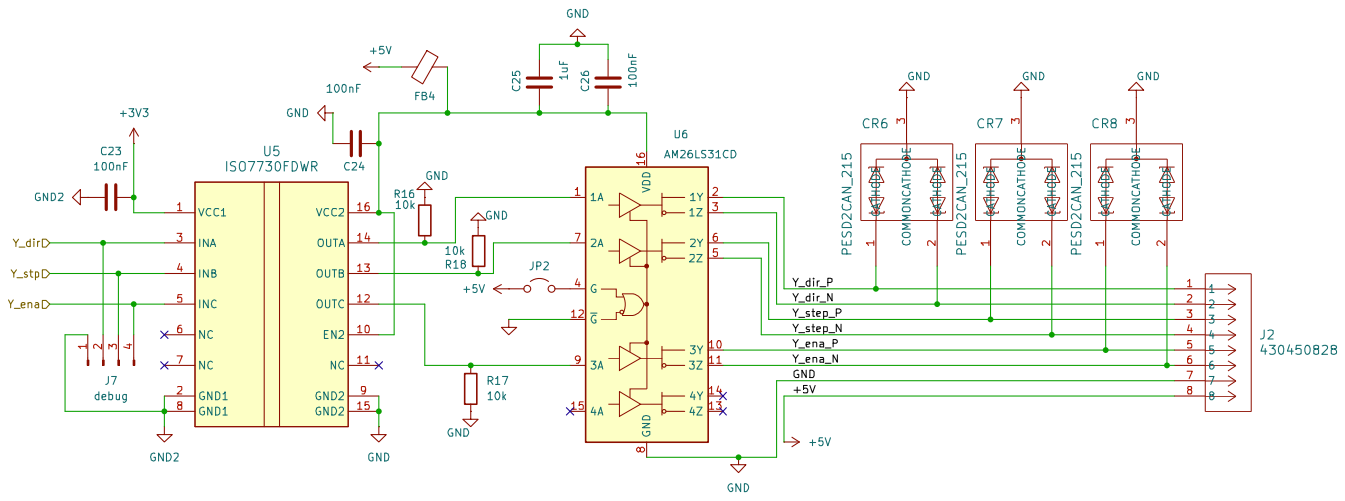
[picture p19: page 6]

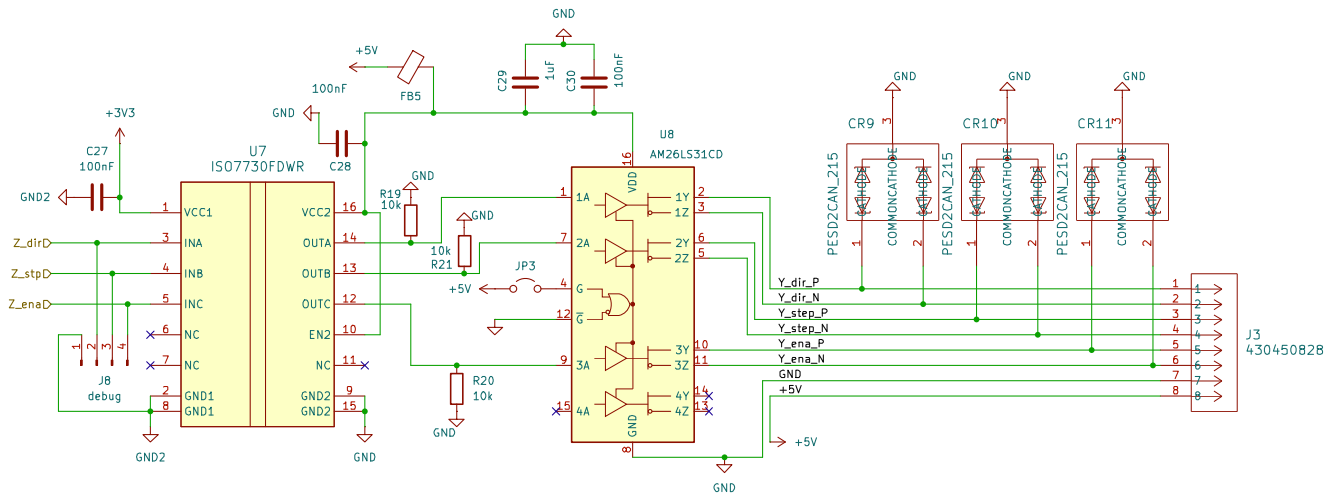
[picture p20: page 7]

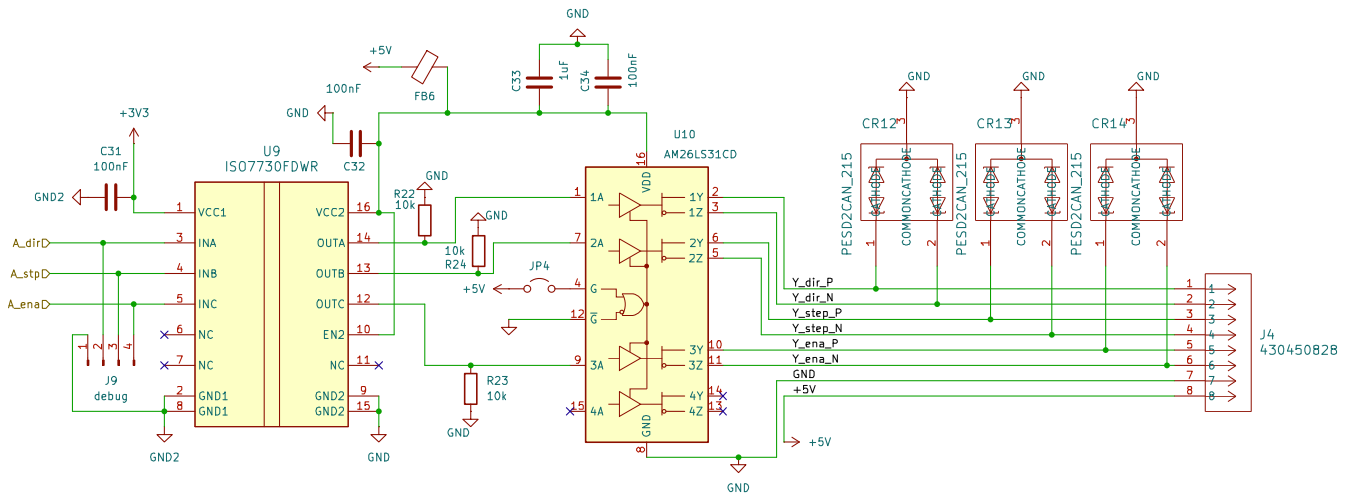
[picture p21: page 8]

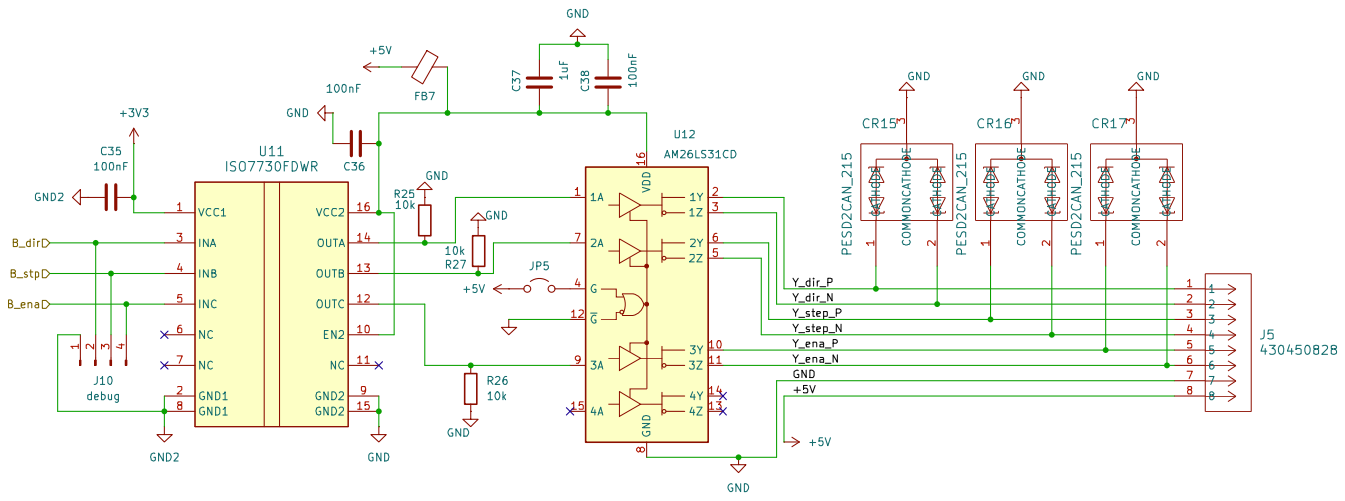
[picture p22: page 9]

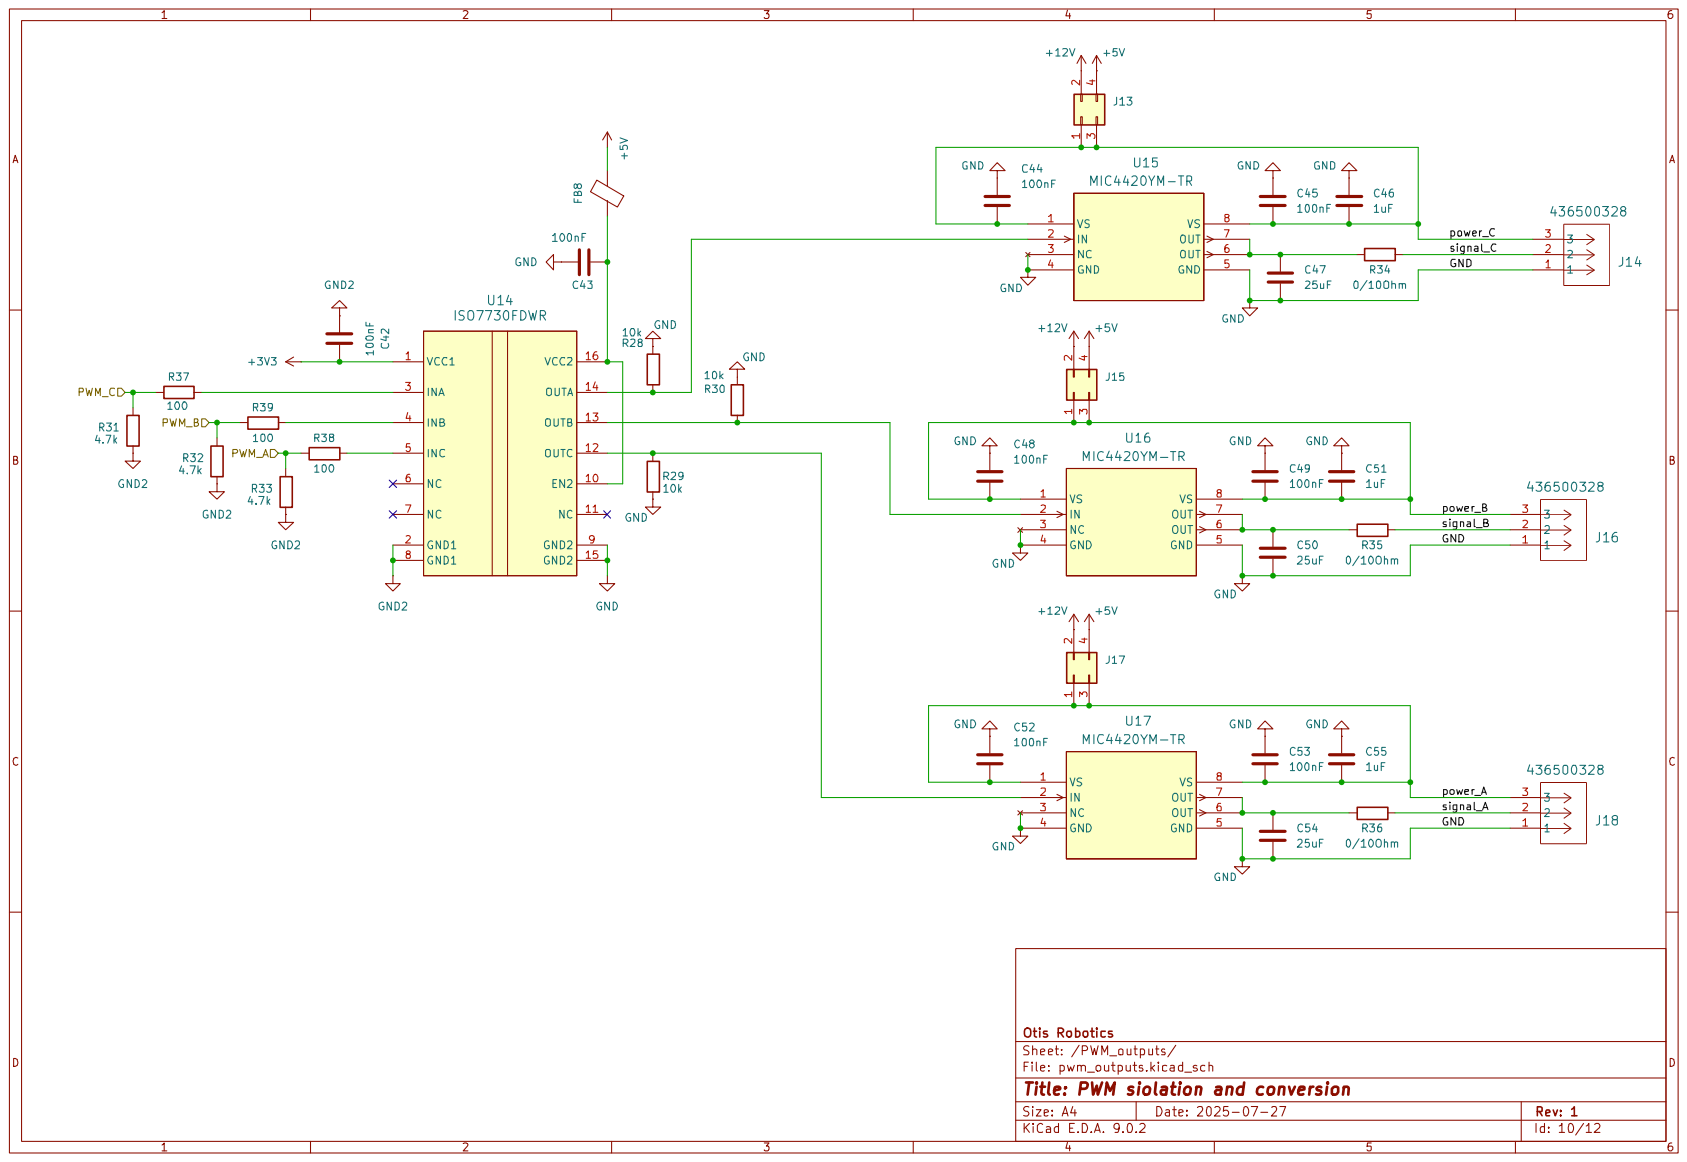
[picture p23: page 10]

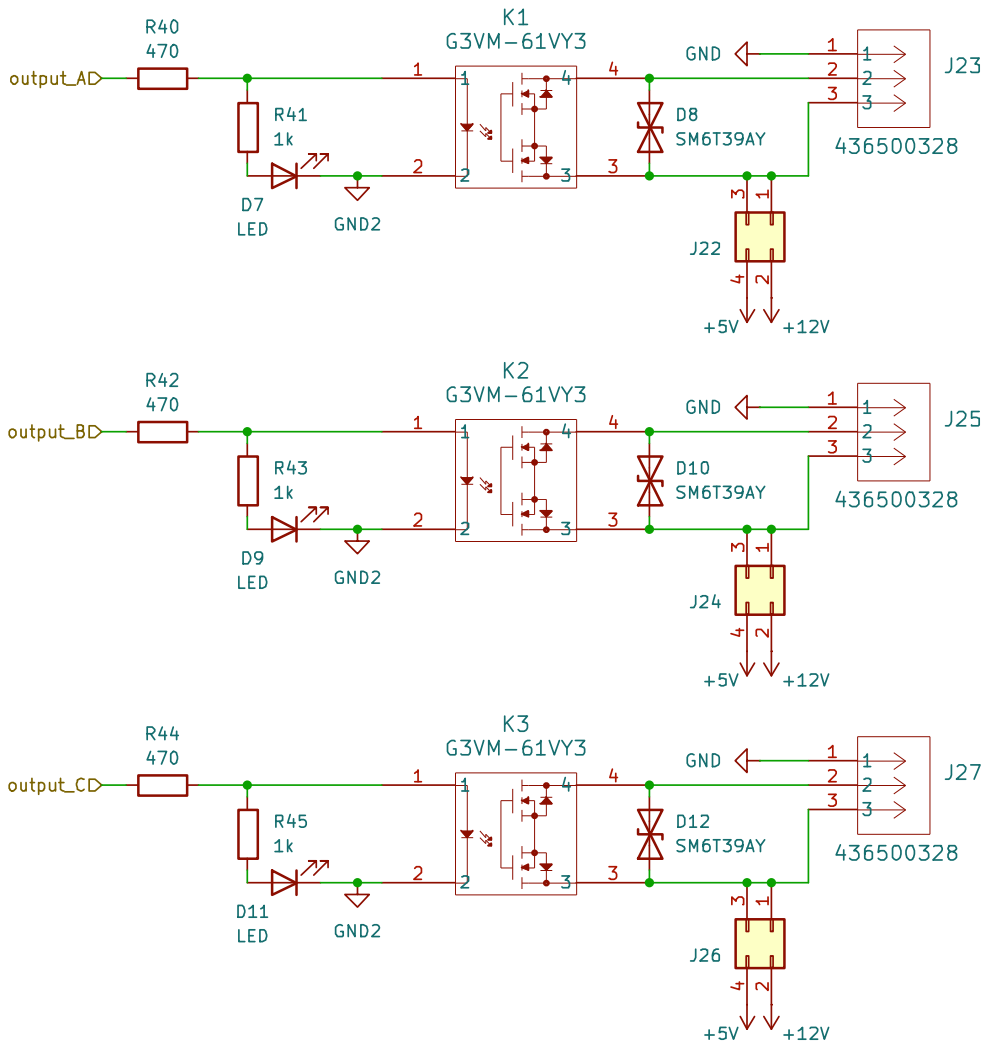
[picture p24: page 11]

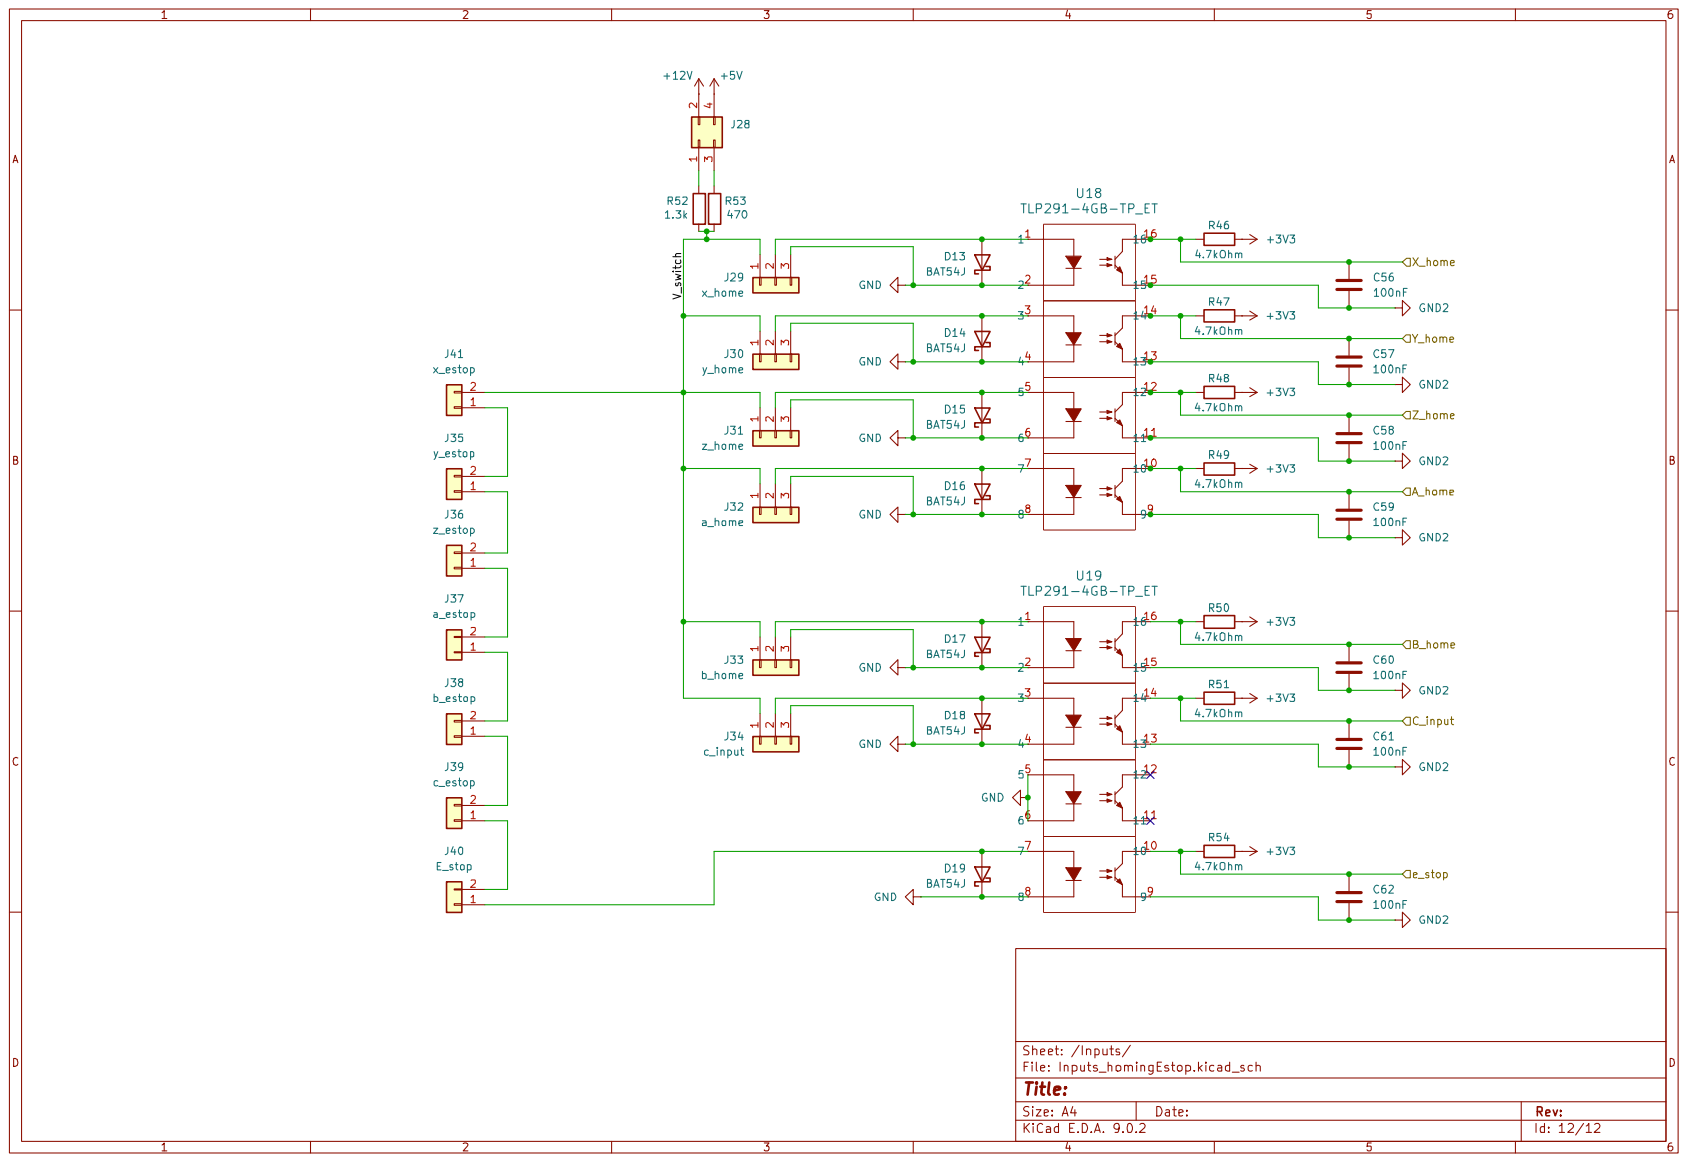
[picture p25: page 12]
