LukasOtis/ExArm/(commit log)

2025-07-16 Setup ROS2 for robot arm control (#1)
    * Initialize ROS2 robot arm project with comprehensive documentation
    * Add development setup docs and deployment scripts for ROS2 robot arm
    * Refactor development setup docs and add direct RPi development script
    * Update development workflow to direct Raspberry Pi development
    * Add X11 forwarding and visualization support for RPi development
    * Enhance X11 forwarding doc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
    [robot_arm.urdf.xacro]
2025-07-17 Evaluate Pi for repository tasks (#2)
    * Add comprehensive hardware analysis for Pi 4B vs Pi 5 robot arm project
    * Add comprehensive GRBL-on-Pico architecture analysis document
    * Add comprehensive robot arm hardware analysis and architecture design
    * Checkpoint before follow-up message
    * Add grblHAL integration for robot arm control with ROS2 bridge
    * Update hardware config with precise motor settings and 5V logic considerations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
2025-07-17 Add files via upload
    Added minimalistic GRBL repo for ARM config
2025-07-17 getting base version for RobotARM of GRBL to compile
    [config.h]
2025-08-24 trials in GRBL compile
    [12V_converter.kicad_sch, 5V_converter.kicad_sch, 5V_isolator.kicad_sch, BOM_with_all_Digi_Key_numbers.xlsx, Inputs_homingEstop.kicad_sch, Pico2Breakout.kicad_pcb, Pico2Breakout.kicad_sch, a_axis.kicad_sch]
2025-08-25 got PWM to return OK
    [config.h]
2025-08-25 resolved SDK compiling issues
    [config.h]
2025-08-25 Implement auxiliary output plugin (M210-M215) for relay control
    - Add M-codes 210-215 to user_mcode_t enum
    - Create aux_output_m210.h header with plugin interface
    - Implement aux_output_m210.c with GPIO control logic
    - Add AUX_OUTPUT_ENABLE configuration
    - Integrate plugin into driver initialization
    - Update CMakeLists.txt to include new plugin source
    - Successfully compiles and generates firmware
2025-08-25 Fix M280 command compatibility by properly chaining M-code handlers
    - Increment build version to 25082503
    - Fix auxiliary output plugin to properly chain with existing M-code handlers
    - Ensure PWM servo plugin (M280) continues to work alongside auxiliary outputs
    - Properly implement chaining in check, validate, and execute functions
    - Maintain backward compatibility with existing plugins
2025-08-25 Update README.md to reflect current firmware capabilities
    - Update status to show fully functional with working plugins
    - Add comprehensive plugin documentation (M280, M210-M215)
    - Update pin assignments to match current configuration
    - Add current build information (version 25082503)
    - Document all available commands and their usage
    - Update success criteria to reflect completed hardware testing
    - Add plugin development resources and examples
2025-08-26 got three axis version working with minimal impelentation
    [config.h]
2025-08-26 Revert to stable 3-axis configuration with PIO step control
    - Reverted my_machine.h to use BOARD_GENERIC and generic_map.h
    - Set N_AXIS to 3 (X, Y, Z axes)
    - Removed 6-axis and 8-axis board map handling from driver.h
    - Maintains PIO-based step control for efficient 3-axis operation
    - All safety features disabled for testing
    - USB serial communication enabled
    - Build successful with no N_AXIS redefinition warnings
    [driver.h, my_machine.h]
2025-08-26 PWM controll implemented
2025-08-28 Steppers (PIO) PWM (Servo+DutyCycle) and Outputs owrking
    [Pico2Breakout.kicad_pcb]
2025-08-28 directory cleanup
    [config.h]
2025-11-30 working board update
    [BOM_with_all_Digi_Key_numbers.xlsx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]
