LukasOtis/ExArm/(notices)

Notices in the files:
grblhal_integration/firmware_GRBL/ioports_analog.c:
grblHAL is free software: you can redistribute it and/or modify
it under the terms of the GNU General Public License as published by
the Free Software Foundation, either version 3 of the License, or
(at your option) any later version.
